binkul/Atari_65XE_scheme/README.md

# Atari_65XE_scheme
1) Improve GND project
2) Remove GTIA fixer (can be made over normal position)
3) 1 MB by Pasiu was added directy on board
4) Video is made by THT elements
5) Four OS
6) Up to eight Super Cartridges inside (MAC65, Action!, Basic XE, Basic XL, Atari Basic)
