binkul/Atari_65XE_scheme/Atari ITX SCH.pdf

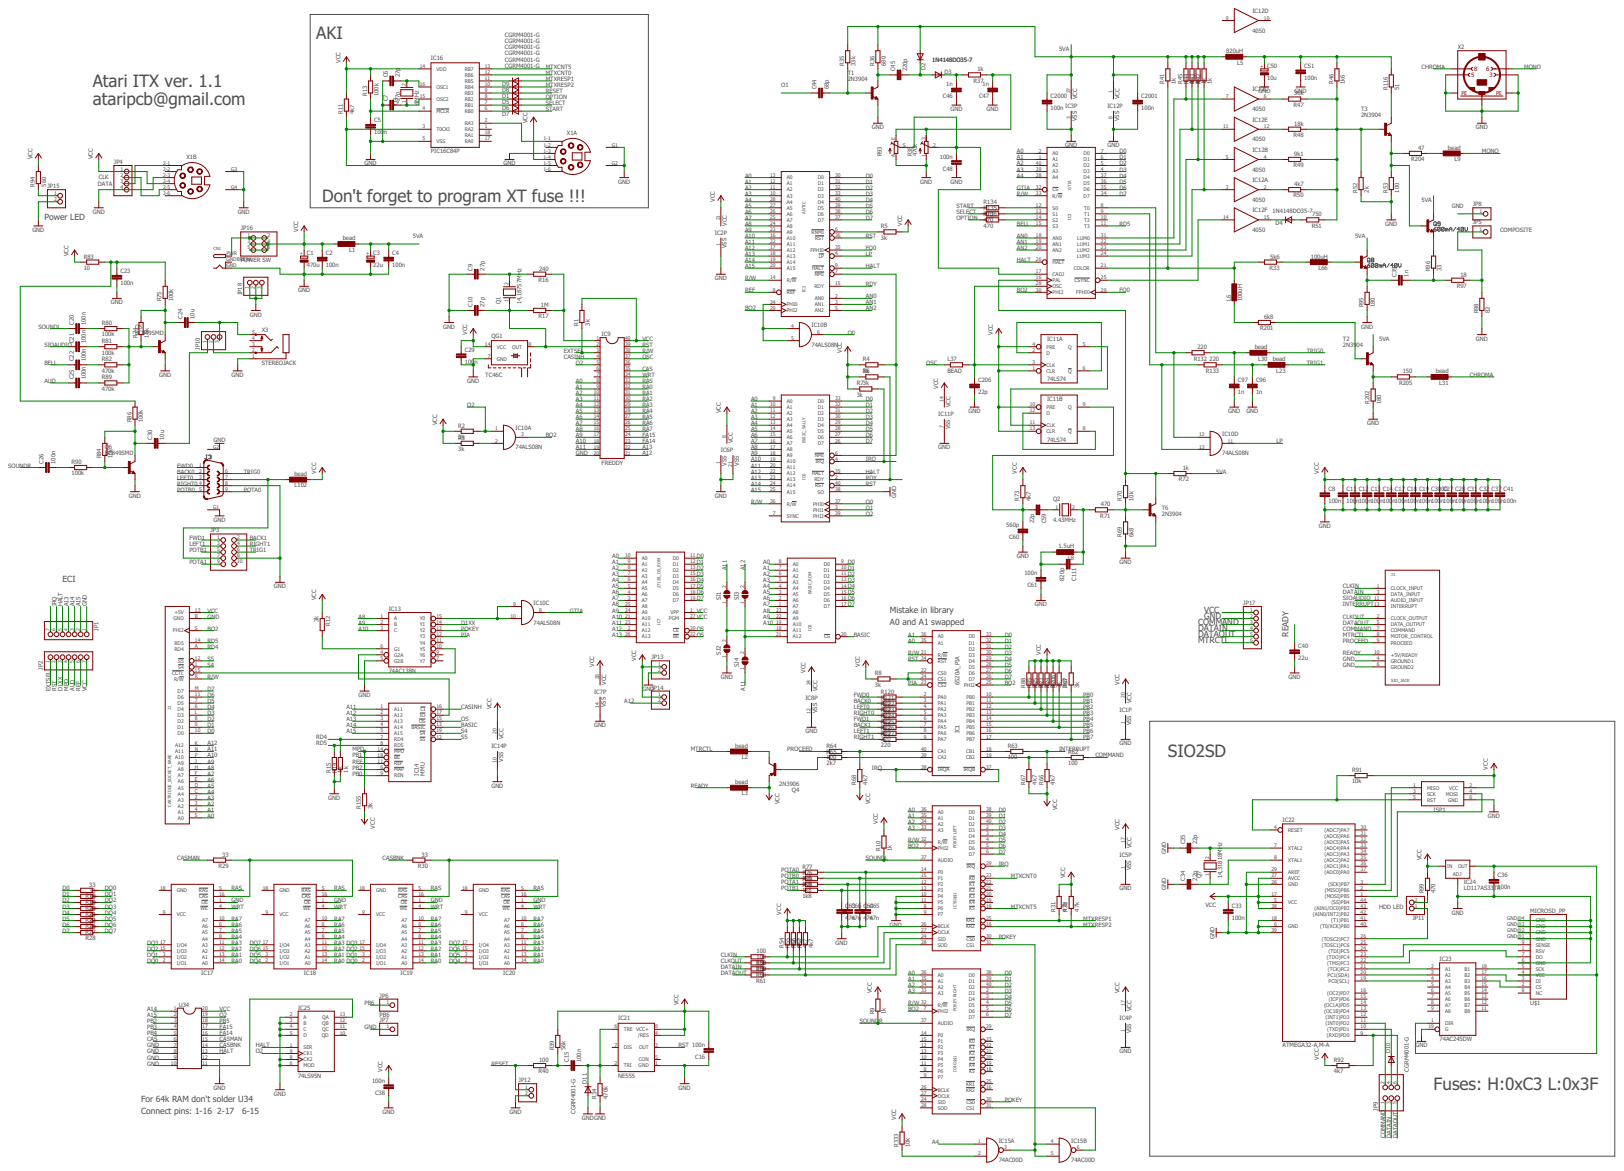
[picture p1: page 1]

Don't forget to program XT fuse !!!

VSS VSS VCC VSS

VCC VSS

For 64k RAM don't solder U34
Connect pins: 1-16 2-17 6-15
