binkul/Atari_65XE_scheme/Atari 130XE.kicad_pcb

## KiCad design Atari 130XE.kicad_pcb (2020-11-24)

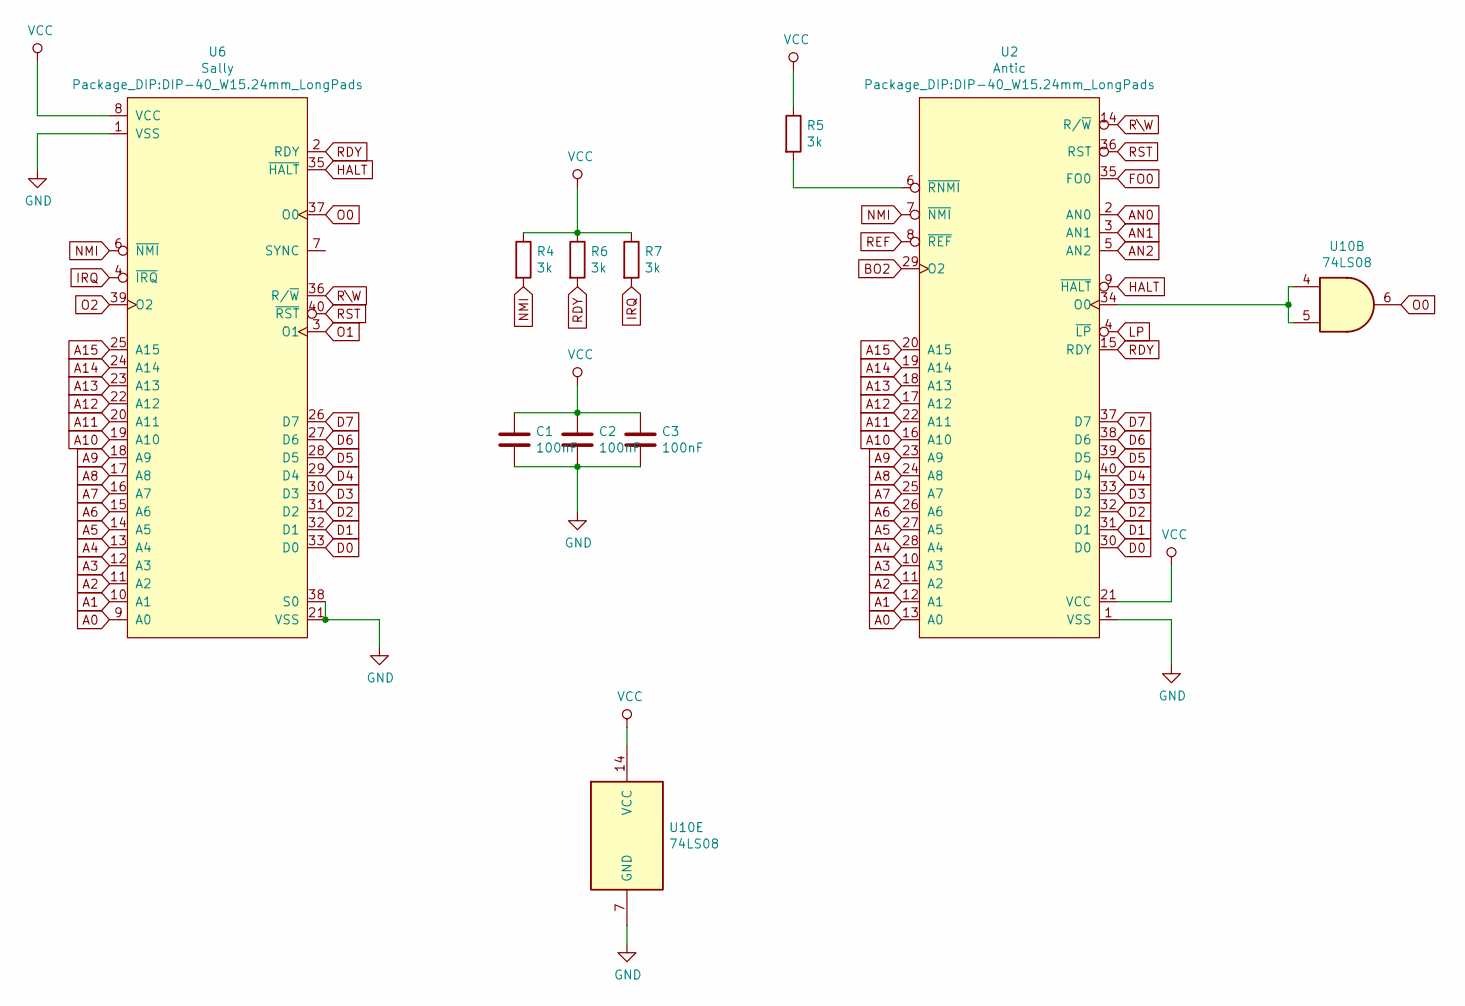
[picture p2: schematic Sally and Antic.sch]

Parts:
C1, C2, C3: 100nF; C_Disc_D5.0mm_W2.5mm_P5.00mm
R4, R5, R6, R7: 3k; R_Axial_DIN0207_L3.6mm_D2.2mm_P10.16mm_Horizontal
U2: Antic; DIP-40_W15.24mm_LongPads
U6: Sally; DIP-40_W15.24mm_LongPads
U10: 74LS08; DIP-14_W7.62mm_Socket_LongPads

Connections:
A0: U2.13 (A0), U6.9 (A0); also elsewhere on the board
A1: U2.12 (A1), U6.10 (A1); also elsewhere on the board
A2: U2.11 (A2), U6.11 (A2); also elsewhere on the board
A3: U2.10 (A3), U6.12 (A3); also elsewhere on the board
A4: U2.28 (A4), U6.13 (A4); also elsewhere on the board
A5: U2.27 (A5), U6.14 (A5); also elsewhere on the board
A6: U2.26 (A6), U6.15 (A6); also elsewhere on the board
A7: U2.25 (A7), U6.16 (A7); also elsewhere on the board
A8: U2.24 (A8), U6.17 (A8); also elsewhere on the board
A9: U2.23 (A9), U6.18 (A9); also elsewhere on the board
A10: U2.16 (A10), U6.19 (A10); also elsewhere on the board
A11: U2.22 (A11), U6.20 (A11); also elsewhere on the board
A12: U2.17 (A12), U6.22 (A12); also elsewhere on the board
A13: U2.18 (A13), U6.23 (A13); also elsewhere on the board
A14: U2.19 (A14), U6.24 (A14); also elsewhere on the board
A15: U2.20 (A15), U6.25 (A15); also elsewhere on the board
AN0: U2.2 (AN0); also elsewhere on the board
AN1: U2.3 (AN1); also elsewhere on the board
AN2: U2.5 (AN2); also elsewhere on the board
BO2: U2.29 (O2); also elsewhere on the board
D0: U2.30 (D0), U6.33 (D0); also elsewhere on the board
D1: U2.31 (D1), U6.32 (D1); also elsewhere on the board
D2: U2.32 (D2), U6.31 (D2); also elsewhere on the board
D3: U2.33 (D3), U6.30 (D3); also elsewhere on the board
D4: U2.40 (D4), U6.29 (D4); also elsewhere on the board
D5: U2.39 (D5), U6.28 (D5); also elsewhere on the board
D6: U2.38 (D6), U6.27 (D6); also elsewhere on the board
D7: U2.37 (D7), U6.26 (D7); also elsewhere on the board
FO0: U2.35 (FO0); also elsewhere on the board
GND: C1.2, C2.2, C3.2, U2.1 (VSS), U6.1 (VSS), U6.21 (VSS), U6.38 (S0), U10.7 (GND); also elsewhere on the board
HALT: U2.9 (~HALT), U6.35 (~HALT); also elsewhere on the board
IRQ: R7.2, U6.4 (~IRQ); also elsewhere on the board
LP: U2.4 (~LP); also elsewhere on the board
NMI: R4.2, U2.7 (~NMI), U6.6 (~NMI)
unnamed: R5.2, U2.6 (~RNMI)
unnamed: U2.34 (O0), U10.4, U10.5
O0: U6.37 (O0), U10.6; also elsewhere on the board
O1: U6.3 (O1); also elsewhere on the board
O2: U6.39 (O2); also elsewhere on the board
RDY: R6.2, U2.15 (RDY), U6.2 (RDY)
REF: U2.8 (~REF); also elsewhere on the board
RST: U2.36 (RST), U6.40 (~RST); also elsewhere on the board
R\W: U2.14 (R/~W), U6.36 (R/~W); also elsewhere on the board
VCC: C1.1, C2.1, C3.1, R4.1, R5.1, R6.1, R7.1, U2.21 (VCC), U6.8 (VCC), U10.14 (VCC); also elsewhere on the board

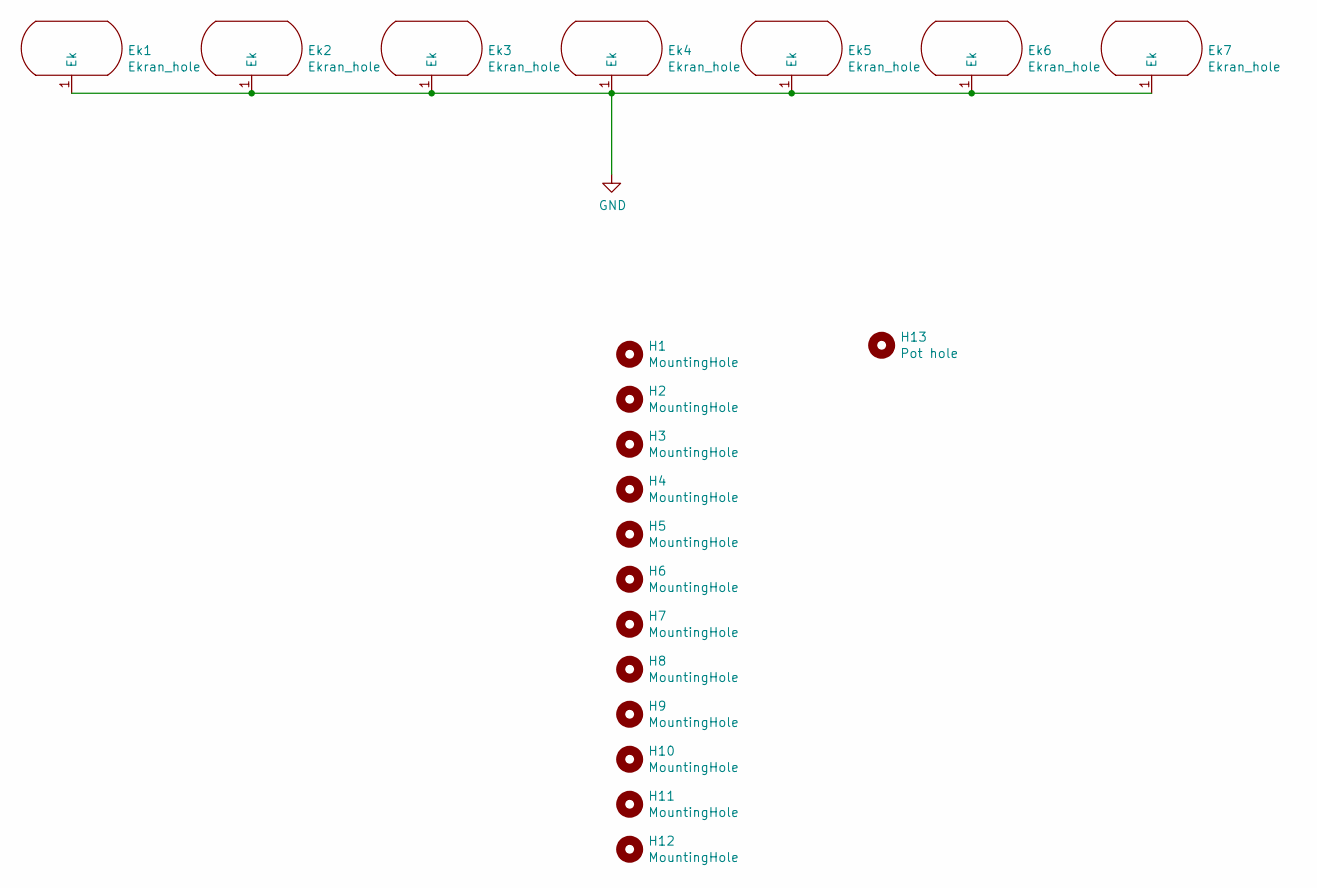
[picture p3: schematic Holes.sch]

Parts:
Ek1, Ek2, Ek3, Ek4, Ek5, Ek6, Ek7: Ekran_hole; Ekran_GND
H1, H2: MountingHole; Big_hole
H3, H4: MountingHole; Medium_hole
H5, H6, H7, H10, H11, H12: MountingHole; Hole_3.4mm
H8, H9: MountingHole; Hole_4.4mm
H13: Pot hole; MountingHole_3.2mm_M3

Connections:
GND: Ek1.1, Ek2.1, Ek3.1, Ek4.1, Ek5.1, Ek6.1, Ek7.1; also elsewhere on the board

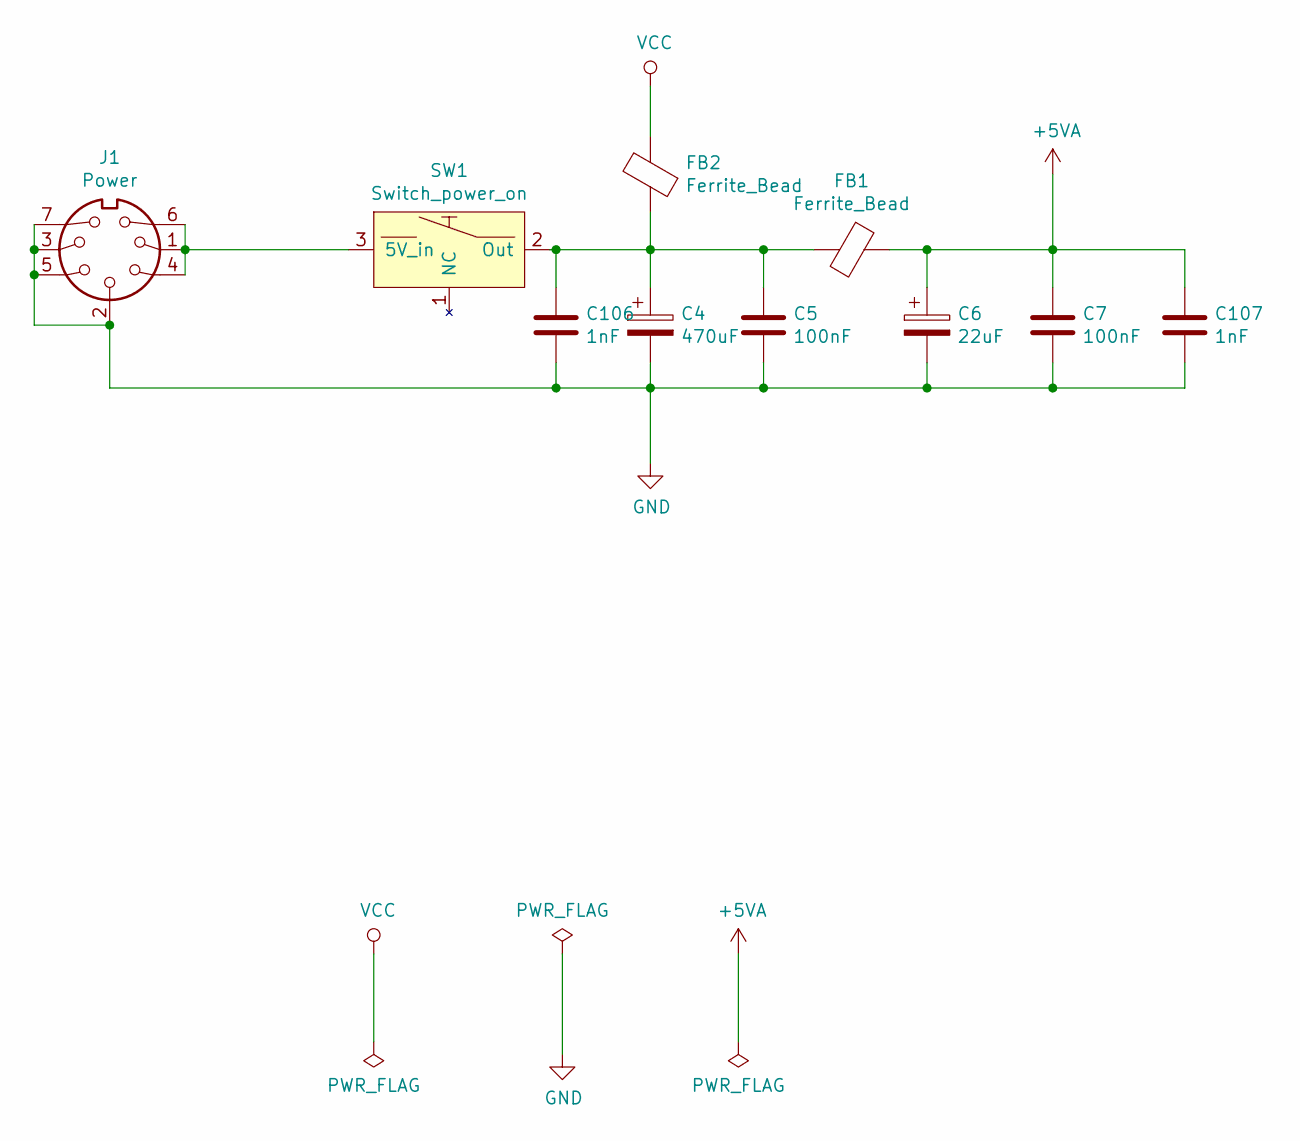
[picture p4: schematic Power.sch]

Parts:
C4: 470uF; CP_Radial_D10.0mm_P5.00mm
C5, C7: 100nF; C_Disc_D5.0mm_W2.5mm_P5.00mm
C6: 22uF; CP_Radial_D5.0mm_P2.00mm
C106, C107: 1nF; C_Disc_D5.0mm_W2.5mm_P5.00mm
FB1, FB2: Ferrite_Bead; L_Axial_L9.5mm_D4.0mm_P12.70mm_Horizontal_Fastron_SMCC
J1: Power; DIN_7_pin
SW1: Switch_power_on; Switch_ON-OFF

Connections:
+5VA: C6.1, C7.1, C107.1, FB1.1; also elsewhere on the board
GND: C4.2, C5.2, C6.2, C7.2, C106.2, C107.2, J1.2, J1.3, J1.5, J1.7; also elsewhere on the board
unnamed: C4.1, C5.1, C106.1, FB1.2, FB2.1, SW1.2 (Out)
unnamed: J1.1, J1.4, J1.6, SW1.3 (5V_in)
VCC: FB2.2; also elsewhere on the board

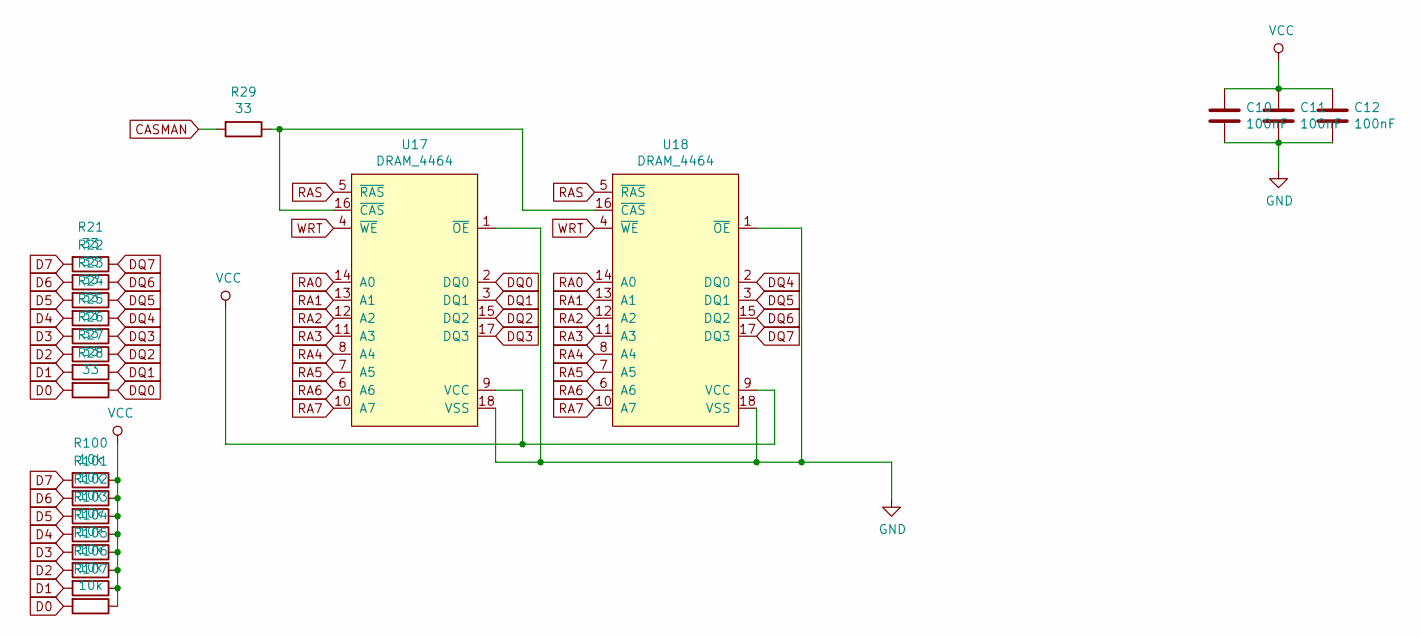
[picture p5: schematic Memory.sch]

Parts:
C10, C11, C12: 100nF; C_Disc_D5.0mm_W2.5mm_P5.00mm
R21, R22, R23, R24, R25, R26, R27, R28: 33; R_1206_3216Metric_Pad1.42x1.75mm_HandSolder
R29: 33; R_Axial_DIN0207_L3.6mm_D2.2mm_P10.16mm_Horizontal
R100, R101, R102, R103, R104, R105, R106, R107: 10k; R_1206_3216Metric_Pad1.42x1.75mm_HandSolder
U17, U18: DRAM_4464; DIP-18_W7.62mm_LongPads

Connections:
CASMAN: R29.2; also elsewhere on the board
D0: R28.2, R107.2; also elsewhere on the board
D1: R27.2, R106.2; also elsewhere on the board
D2: R26.2, R105.2; also elsewhere on the board
D3: R25.2, R104.2; also elsewhere on the board
D4: R24.2, R103.2; also elsewhere on the board
D5: R23.2, R102.2; also elsewhere on the board
D6: R22.2, R101.2; also elsewhere on the board
D7: R21.2, R100.2; also elsewhere on the board
DQ0: R28.1, U17.2 (DQ0); also elsewhere on the board
DQ1: R27.1, U17.3 (DQ1); also elsewhere on the board
DQ2: R26.1, U17.15 (DQ2); also elsewhere on the board
DQ3: R25.1, U17.17 (DQ3); also elsewhere on the board
DQ4: R24.1, U18.2 (DQ0); also elsewhere on the board
DQ5: R23.1, U18.3 (DQ1); also elsewhere on the board
DQ6: R22.1, U18.15 (DQ2); also elsewhere on the board
DQ7: R21.1, U18.17 (DQ3); also elsewhere on the board
GND: C10.2, C11.2, C12.2, U17.1 (~OE), U17.18 (VSS), U18.1 (~OE), U18.18 (VSS); also elsewhere on the board
unnamed: R29.1, U17.16 (~CAS), U18.16 (~CAS)
RA0: U17.14 (A0), U18.14 (A0); also elsewhere on the board
RA1: U17.13 (A1), U18.13 (A1); also elsewhere on the board
RA2: U17.12 (A2), U18.12 (A2); also elsewhere on the board
RA3: U17.11 (A3), U18.11 (A3); also elsewhere on the board
RA4: U17.8 (A4), U18.8 (A4); also elsewhere on the board
RA5: U17.7 (A5), U18.7 (A5); also elsewhere on the board
RA6: U17.6 (A6), U18.6 (A6); also elsewhere on the board
RA7: U17.10 (A7), U18.10 (A7); also elsewhere on the board
RAS: U17.5 (~RAS), U18.5 (~RAS); also elsewhere on the board
VCC: C10.1, C11.1, C12.1, R100.1, R101.1, R102.1, R103.1, R104.1, R105.1, R106.1, R107.1, U17.9 (VCC), U18.9 (VCC); also elsewhere on the board
WRT: U17.4 (~WE), U18.4 (~WE); also elsewhere on the board

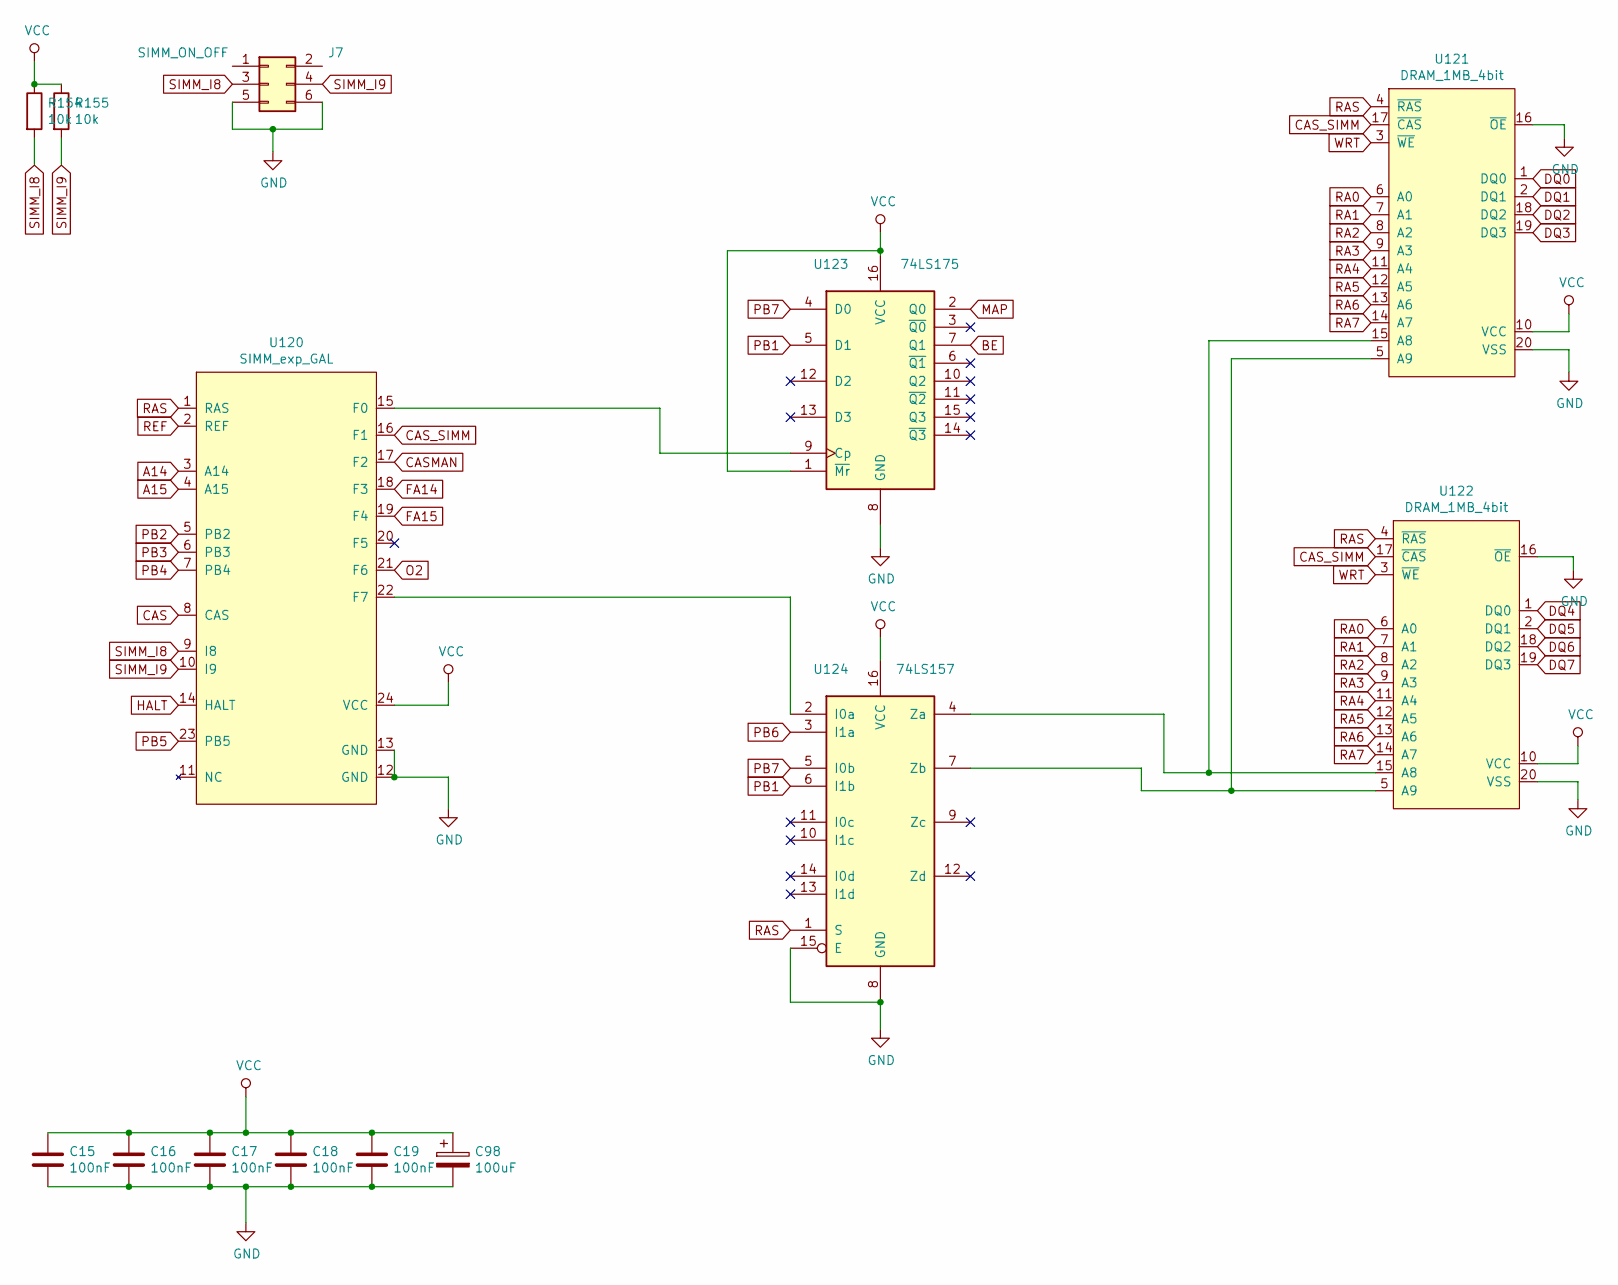
[picture p6: schematic External Memory.sch, External 196Kb]

Parts:
C15, C16, C17: 100nF; C_Disc_D5.0mm_W2.5mm_P5.00mm
C18, C19: 100nF; C_1206_3216Metric_Pad1.42x1.75mm_HandSolder
C98: 100uF; CP_Radial_D6.3mm_P2.50mm
J7: SIMM_ON_OFF; PinHeader_2x03_P2.54mm_Vertical
R154, R155: 10k; R_1206_3216Metric_Pad1.42x1.75mm_HandSolder
U120: SIMM_exp_GAL; DIP-24_W7.62mm_Socket_LongPads
U121, U122: DRAM_1MB_4bit; SOJ-26
U123: 74LS175; SOIC-16_3.9x9.9mm_P1.27mm
U124: 74LS157; SOIC-16_3.9x9.9mm_P1.27mm

Connections:
A14: U120.3 (A14); also elsewhere on the board
A15: U120.4 (A15); also elsewhere on the board
BE: U123.7 (Q1); also elsewhere on the board
CAS: U120.8 (CAS); also elsewhere on the board
CASMAN: U120.17 (F2); also elsewhere on the board
CAS_SIMM: U120.16 (F1), U121.17 (~CAS), U122.17 (~CAS)
DQ0: U121.1 (DQ0); also elsewhere on the board
DQ1: U121.2 (DQ1); also elsewhere on the board
DQ2: U121.18 (DQ2); also elsewhere on the board
DQ3: U121.19 (DQ3); also elsewhere on the board
DQ4: U122.1 (DQ0); also elsewhere on the board
DQ5: U122.2 (DQ1); also elsewhere on the board
DQ6: U122.18 (DQ2); also elsewhere on the board
DQ7: U122.19 (DQ3); also elsewhere on the board
FA14: U120.18 (F3); also elsewhere on the board
FA15: U120.19 (F4); also elsewhere on the board
GND: C15.2, C16.2, C17.2, C18.2, C19.2, C98.2, J7.5, J7.6, U120.12 (GND), U120.13 (GND), U121.16 (~OE), U121.20 (VSS), U122.16 (~OE), U122.20 (VSS), U123.8 (GND), U124.8 (GND), U124.15 (E); also elsewhere on the board
HALT: U120.14 (HALT); also elsewhere on the board
MAP: U123.2 (Q0); also elsewhere on the board
unnamed: U120.15 (F0), U123.9 (Cp)
unnamed: U120.22 (F7), U124.2 (I0a)
unnamed: U121.5 (A9), U122.5 (A9), U124.7 (Zb)
unnamed: U121.15 (A8), U122.15 (A8), U124.4 (Za)
O2: U120.21 (F6); also elsewhere on the board
PB1: U123.5 (D1), U124.6 (I1b); also elsewhere on the board
PB2: U120.5 (PB2); also elsewhere on the board
PB3: U120.6 (PB3); also elsewhere on the board
PB4: U120.7 (PB4); also elsewhere on the board
PB5: U120.23 (PB5); also elsewhere on the board
PB6: U124.3 (I1a); also elsewhere on the board
PB7: U123.4 (D0), U124.5 (I0b); also elsewhere on the board
RA0: U121.6 (A0), U122.6 (A0); also elsewhere on the board
RA1: U121.7 (A1), U122.7 (A1); also elsewhere on the board
RA2: U121.8 (A2), U122.8 (A2); also elsewhere on the board
RA3: U121.9 (A3), U122.9 (A3); also elsewhere on the board
RA4: U121.11 (A4), U122.11 (A4); also elsewhere on the board
RA5: U121.12 (A5), U122.12 (A5); also elsewhere on the board
RA6: U121.13 (A6), U122.13 (A6); also elsewhere on the board
RA7: U121.14 (A7), U122.14 (A7); also elsewhere on the board
RAS: U120.1 (RAS), U121.4 (~RAS), U122.4 (~RAS), U124.1 (S); also elsewhere on the board
REF: U120.2 (REF); also elsewhere on the board
SIMM_I8: J7.3, R154.2, U120.9 (I8)
SIMM_I9: J7.4, R155.2, U120.10 (I9)
VCC: C15.1, C16.1, C17.1, C18.1, C19.1, C98.1, R154.1, R155.1, U120.24 (VCC), U121.10 (VCC), U122.10 (VCC), U123.1 (~Mr), U123.16 (VCC), U124.16 (VCC); also elsewhere on the board
WRT: U121.3 (~WE), U122.3 (~WE); also elsewhere on the board

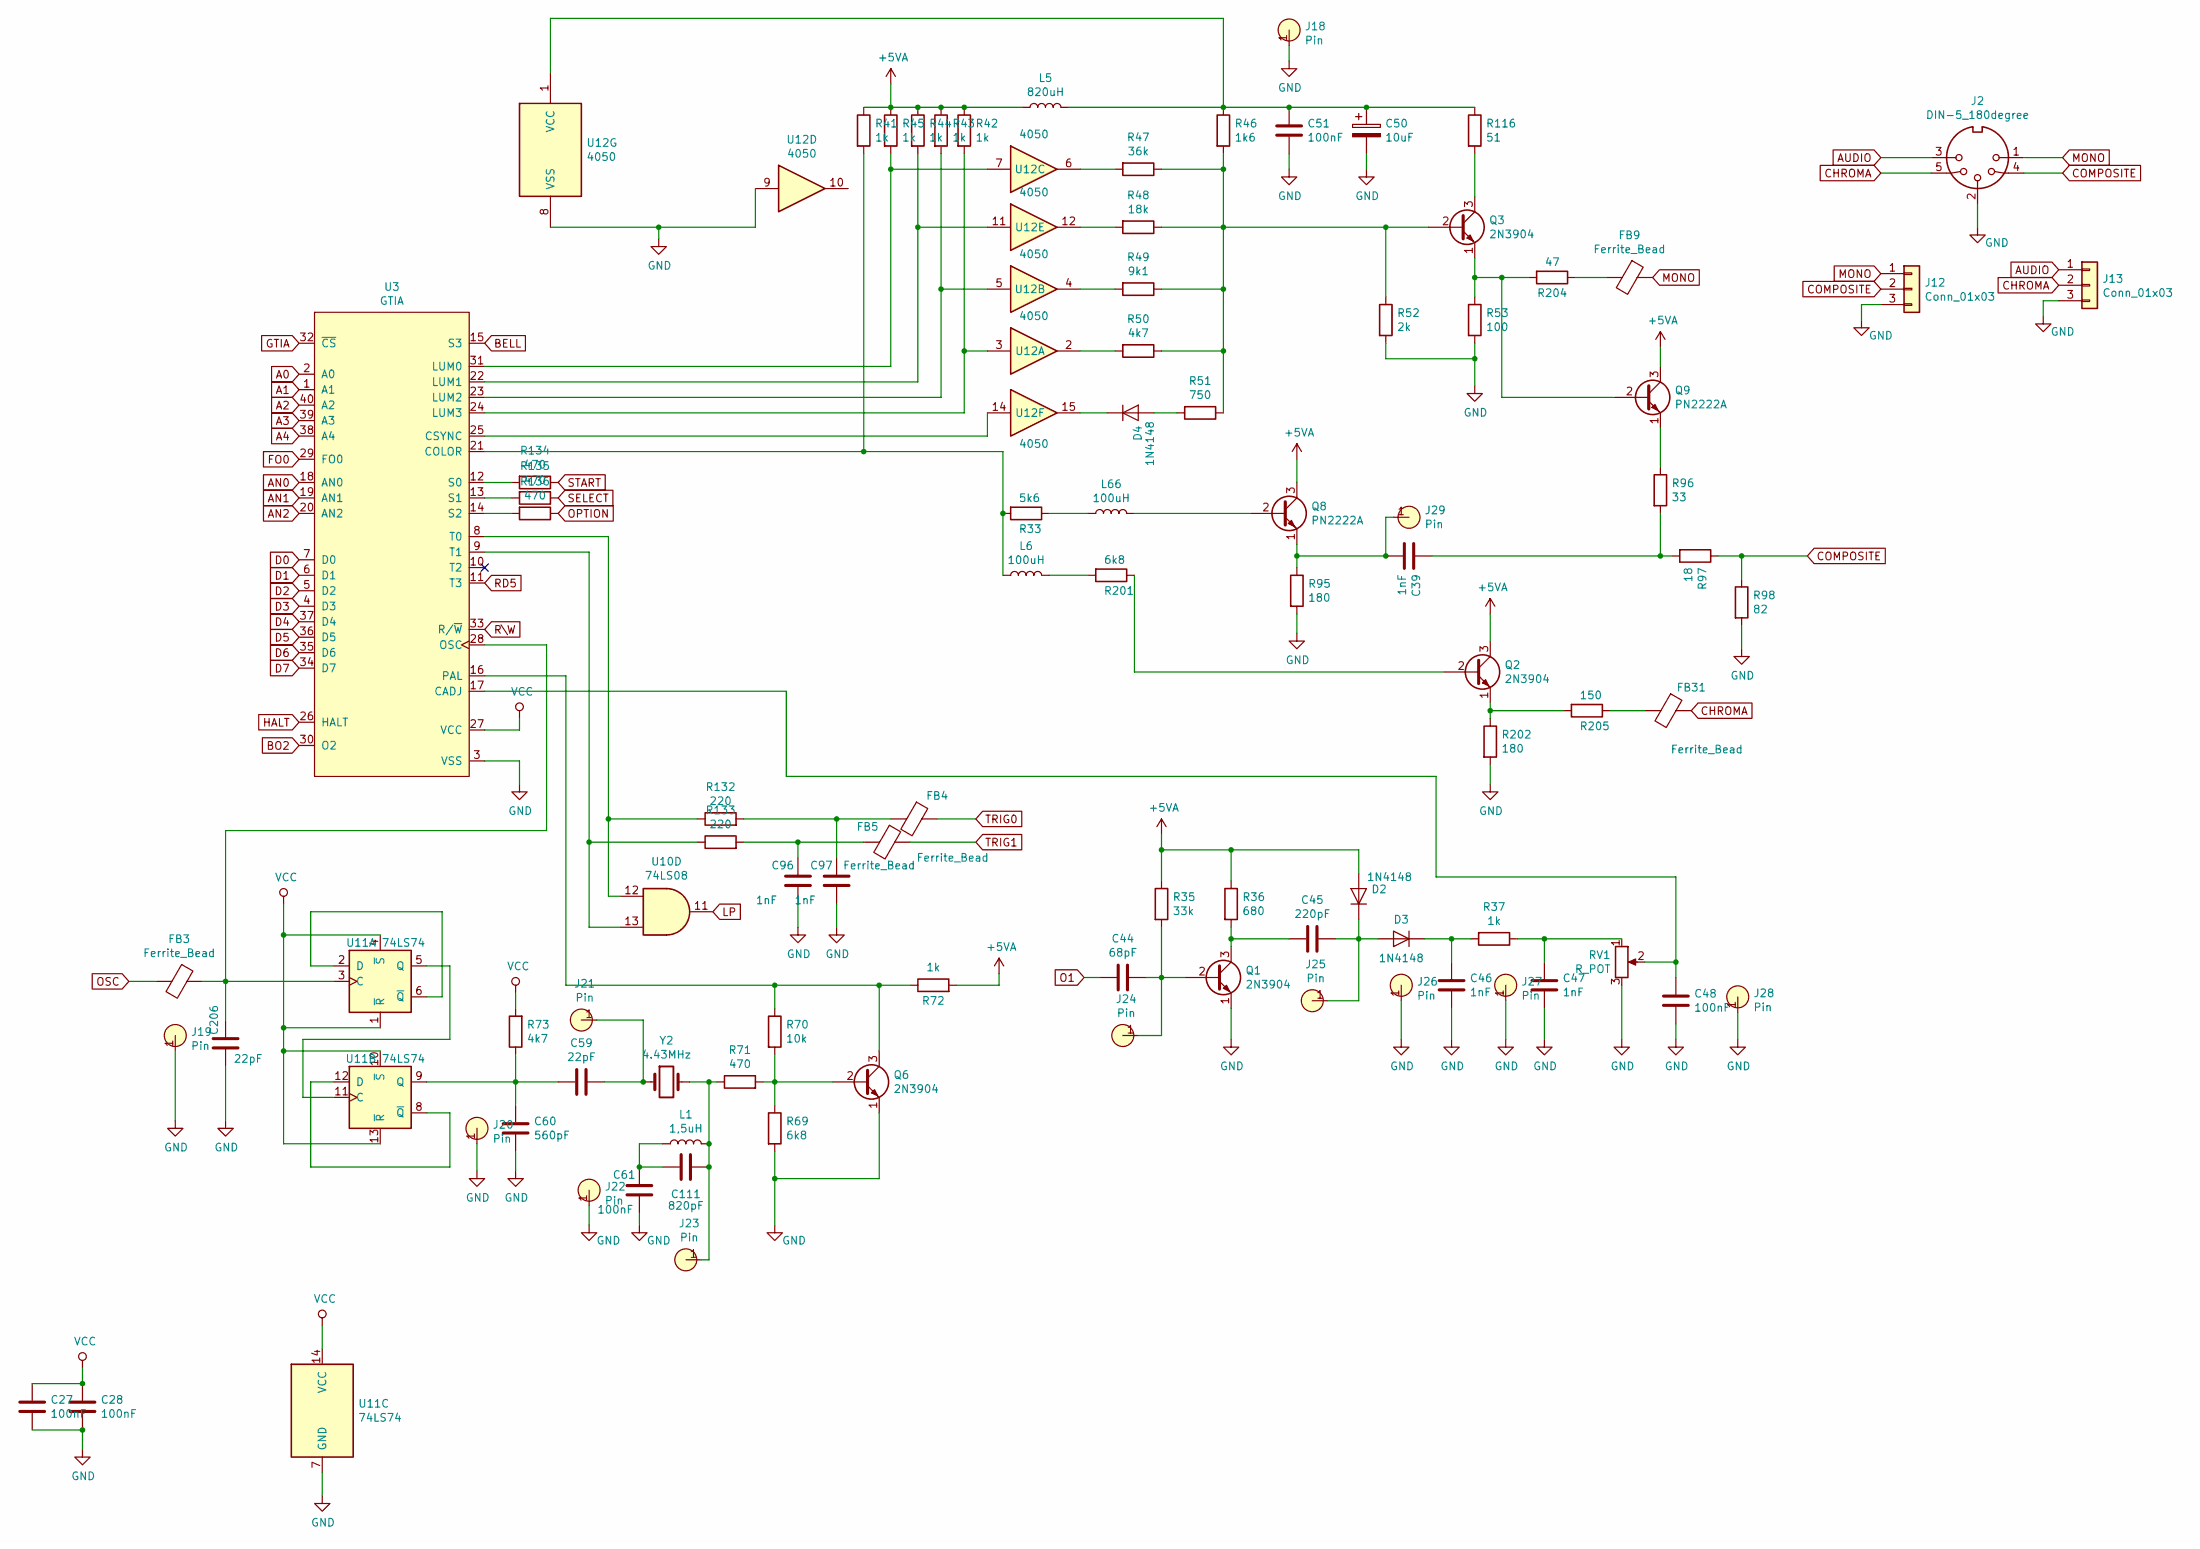
[picture p7: schematic GTIA.sch]

Parts:
C27, C28, C48, C51, C61: 100nF; C_Disc_D5.0mm_W2.5mm_P5.00mm
C39, C46, C47, C96, C97: 1nF; C_Disc_D5.0mm_W2.5mm_P5.00mm
C44: 68pF; C_Disc_D3.0mm_W2.0mm_P2.50mm
C45: 220pF; C_Disc_D5.0mm_W2.5mm_P5.00mm
C50: 10uF; CP_Radial_D6.3mm_P2.50mm
C59, C206: 22pF; C_Disc_D5.0mm_W2.5mm_P5.00mm
C60: 560pF; C_Disc_D5.0mm_W2.5mm_P5.00mm
C111: 820pF; C_Disc_D5.0mm_W2.5mm_P5.00mm
D2, D3, D4: 1N4148; D_DO-34_SOD68_P10.16mm_Horizontal
FB3, FB4, FB5, FB9, FB31: Ferrite_Bead; L_Axial_L7.0mm_D3.3mm_P10.16mm_Horizontal_Fastron_MICC
J2: DIN-5_180degree; DIN_5_pin
J12, J13: Conn_01x03; PinHeader_1x03_P2.54mm_Vertical
J18, J19, J20, J21, J22, J23, J24, J25, J26, J27, J28, J29: Pin
L1: 1,5uH; L_Axial_L5.3mm_D2.2mm_P10.16mm_Horizontal_Vishay_IM-1
L5: 820uH; L_Axial_L5.3mm_D2.2mm_P10.16mm_Horizontal_Vishay_IM-1
L6, L66: 100uH; L_Axial_L5.3mm_D2.2mm_P10.16mm_Horizontal_Vishay_IM-1
Q1, Q2, Q3, Q6: 2N3904; TO-92_Inline
Q8, Q9: PN2222A; TO-92_Inline
R33: 5k6; R_Axial_DIN0207_L3.6mm_D2.2mm_P10.16mm_Horizontal
R35: 33k; R_Axial_DIN0207_L3.6mm_D2.2mm_P10.16mm_Horizontal
R36: 680; R_Axial_DIN0207_L3.6mm_D2.2mm_P10.16mm_Horizontal
R37, R41, R42, R43, R44, R45, R72: 1k; R_Axial_DIN0207_L3.6mm_D2.2mm_P10.16mm_Horizontal
R46: 1k6; R_Axial_DIN0207_L3.6mm_D2.2mm_P10.16mm_Horizontal
R47: 36k; R_Axial_DIN0207_L3.6mm_D2.2mm_P10.16mm_Horizontal
R48: 18k; R_Axial_DIN0207_L3.6mm_D2.2mm_P10.16mm_Horizontal
R49: 9k1; R_Axial_DIN0207_L3.6mm_D2.2mm_P10.16mm_Horizontal
R50, R73: 4k7; R_Axial_DIN0207_L3.6mm_D2.2mm_P10.16mm_Horizontal
R51: 750; R_Axial_DIN0207_L3.6mm_D2.2mm_P10.16mm_Horizontal
R52: 2k; R_Axial_DIN0207_L3.6mm_D2.2mm_P10.16mm_Horizontal
R53: 100; R_Axial_DIN0207_L3.6mm_D2.2mm_P10.16mm_Horizontal
R69, R201: 6k8; R_Axial_DIN0207_L3.6mm_D2.2mm_P10.16mm_Horizontal
R70: 10k; R_Axial_DIN0207_L3.6mm_D2.2mm_P10.16mm_Horizontal
R71: 470; R_Axial_DIN0207_L3.6mm_D2.2mm_P10.16mm_Horizontal
R95, R202: 180; R_Axial_DIN0207_L3.6mm_D2.2mm_P10.16mm_Horizontal
R96: 33; R_Axial_DIN0207_L3.6mm_D2.2mm_P10.16mm_Horizontal
R97: 18; R_Axial_DIN0207_L3.6mm_D2.2mm_P10.16mm_Horizontal
R98: 82; R_Axial_DIN0207_L3.6mm_D2.2mm_P10.16mm_Horizontal
R116: 51; R_Axial_DIN0207_L3.6mm_D2.2mm_P10.16mm_Horizontal
R132, R133: 220; R_1206_3216Metric_Pad1.42x1.75mm_HandSolder
R134, R135, R136: 470; R_1206_3216Metric_Pad1.42x1.75mm_HandSolder
R204: 47; R_Axial_DIN0207_L3.6mm_D2.2mm_P10.16mm_Horizontal
R205: 150; R_Axial_DIN0207_L3.6mm_D2.2mm_P10.16mm_Horizontal
RV1: R_POT; Potentiometer_ACP_CA9-V10_Vertical_Hole
U3: GTIA; DIP-40_W15.24mm_LongPads
U10: 74LS08; DIP-14_W7.62mm_Socket_LongPads
U11: 74LS74; DIP-14_W7.62mm_Socket
U12: 4050; DIP-16_W7.62mm_Socket
Y2: 4.43MHz; Crystal_HC18-U_Horizontal

Connections:
+5VA: D2.2 (A), L5.1, Q2.3 (C), Q8.3 (C), Q9.3 (C), R35.1, R36.1, R41.1, R42.1, R43.1, R44.1, R45.1, R72.2; also elsewhere on the board
A0: U3.2 (A0); also elsewhere on the board
A1: U3.1 (A1); also elsewhere on the board
A2: U3.40 (A2); also elsewhere on the board
A3: U3.39 (A3); also elsewhere on the board
A4: U3.38 (A4); also elsewhere on the board
AN0: U3.18 (AN0); also elsewhere on the board
AN1: U3.19 (AN1); also elsewhere on the board
AN2: U3.20 (AN2); also elsewhere on the board
AUDIO: J2.3, J13.1; also elsewhere on the board
BELL: U3.15 (S3); also elsewhere on the board
BO2: U3.30 (O2); also elsewhere on the board
CHROMA: FB31.1, J2.5, J13.2
COMPOSITE: J2.4, J12.2, R97.1, R98.1
D0: U3.7 (D0); also elsewhere on the board
D1: U3.6 (D1); also elsewhere on the board
D2: U3.5 (D2); also elsewhere on the board
D3: U3.4 (D3); also elsewhere on the board
D4: U3.37 (D4); also elsewhere on the board
D5: U3.36 (D5); also elsewhere on the board
D6: U3.35 (D6); also elsewhere on the board
D7: U3.34 (D7); also elsewhere on the board
FO0: U3.29 (FO0); also elsewhere on the board
GND: C27.2, C28.2, C46.1, C47.1, C48.1, C50.2, C51.1, C60.2, C61.2, C96.2, C97.2, C206.2, J2.2, J12.3, J13.3, J18.1, J19.1, J20.1, J22.1, J26.1, J27.1, J28.1, Q1.1 (E), Q6.1 (E), R52.2, R53.2, R69.2, R95.2, R98.2, R202.2, RV1.3, U3.3 (VSS), U11.7 (GND), U12.8 (VSS), U12.9; also elsewhere on the board
GTIA: U3.32 (~CS); also elsewhere on the board
HALT: U3.26 (HALT); also elsewhere on the board
LP: U10.11; also elsewhere on the board
MONO: FB9.1, J2.1, J12.1
unnamed: C39.1, J29.1, Q8.1 (E), R95.1
unnamed: C39.2, R96.2, R97.2
unnamed: C44.1, J24.1, Q1.2 (B), R35.2
unnamed: C45.1, D2.1 (K), D3.2 (A), J25.1
unnamed: C45.2, Q1.3 (C), R36.2
unnamed: C46.2, D3.1 (K), R37.2
unnamed: C47.2, R37.1, RV1.1
unnamed: C48.2, RV1.2, U3.17 (CADJ)
unnamed: C50.1, C51.2, L5.2, R46.1, R116.1, U12.1 (VCC)
unnamed: C59.1, J21.1, Y2.1
unnamed: C59.2, C60.1, R73.1, U11.9 (Q)
unnamed: C96.1, FB5.2, R133.2
unnamed: C97.1, FB4.2, R132.2
unnamed: C111.1, J23.1, L1.2, R71.1, Y2.2
unnamed: C61.1, C111.2, L1.1
unnamed: C206.1, FB3.1, U3.28 (OSC), U11.3 (C)
unnamed: D4.1 (K), U12.15
unnamed: D4.2 (A), R51.2
unnamed: FB9.2, R204.1
unnamed: FB31.2, R205.1
unnamed: L6.1, R33.2, R41.2, U3.21 (COLOR)
unnamed: L6.2, R201.2
unnamed: L66.1, R33.1
unnamed: L66.2, Q8.2 (B)
unnamed: Q2.1 (E), R202.1, R205.2
unnamed: Q2.2 (B), R201.1
unnamed: Q3.1 (E), Q9.2 (B), R53.1, R204.2
unnamed: Q3.2 (B), R46.2, R47.1, R48.1, R49.1, R50.1, R51.1, R52.1
unnamed: Q3.3 (C), R116.2
unnamed: Q6.2 (B), R69.1, R70.2, R71.2
unnamed: Q6.3 (C), R70.1, R72.1, U3.16 (PAL)
unnamed: Q9.1 (E), R96.1
unnamed: R42.2, U3.24 (LUM3), U12.3
unnamed: R43.2, U3.23 (LUM2), U12.5
unnamed: R44.2, U3.22 (LUM1), U12.11
unnamed: R45.2, U3.31 (LUM0), U12.7
unnamed: R47.2, U12.6
unnamed: R48.2, U12.12
unnamed: R49.2, U12.4
unnamed: R50.2, U12.2
unnamed: R132.1, U3.8 (T0), U10.12
unnamed: R133.1, U3.9 (T1), U10.13
unnamed: R134.2, U3.12 (S0)
unnamed: R135.2, U3.13 (S1)
unnamed: R136.2, U3.14 (S2)
unnamed: U11.2 (D), U11.6 (~Q)
unnamed: U11.5 (Q), U11.11 (C)
unnamed: U11.8 (~Q), U11.12 (D)
unnamed: U3.25 (CSYNC), U12.14
O1: C44.2; also elsewhere on the board
OPTION: R136.1; also elsewhere on the board
OSC: FB3.2; also elsewhere on the board
RD5: U3.11 (T3); also elsewhere on the board
R\W: U3.33 (R/~W); also elsewhere on the board
SELECT: R135.1; also elsewhere on the board
START: R134.1; also elsewhere on the board
TRIG0: FB4.1; also elsewhere on the board
TRIG1: FB5.1; also elsewhere on the board
VCC: C27.1, C28.1, R73.2, U3.27 (VCC), U11.1 (~R), U11.4 (~S), U11.10 (~S), U11.13 (~R), U11.14 (VCC); also elsewhere on the board

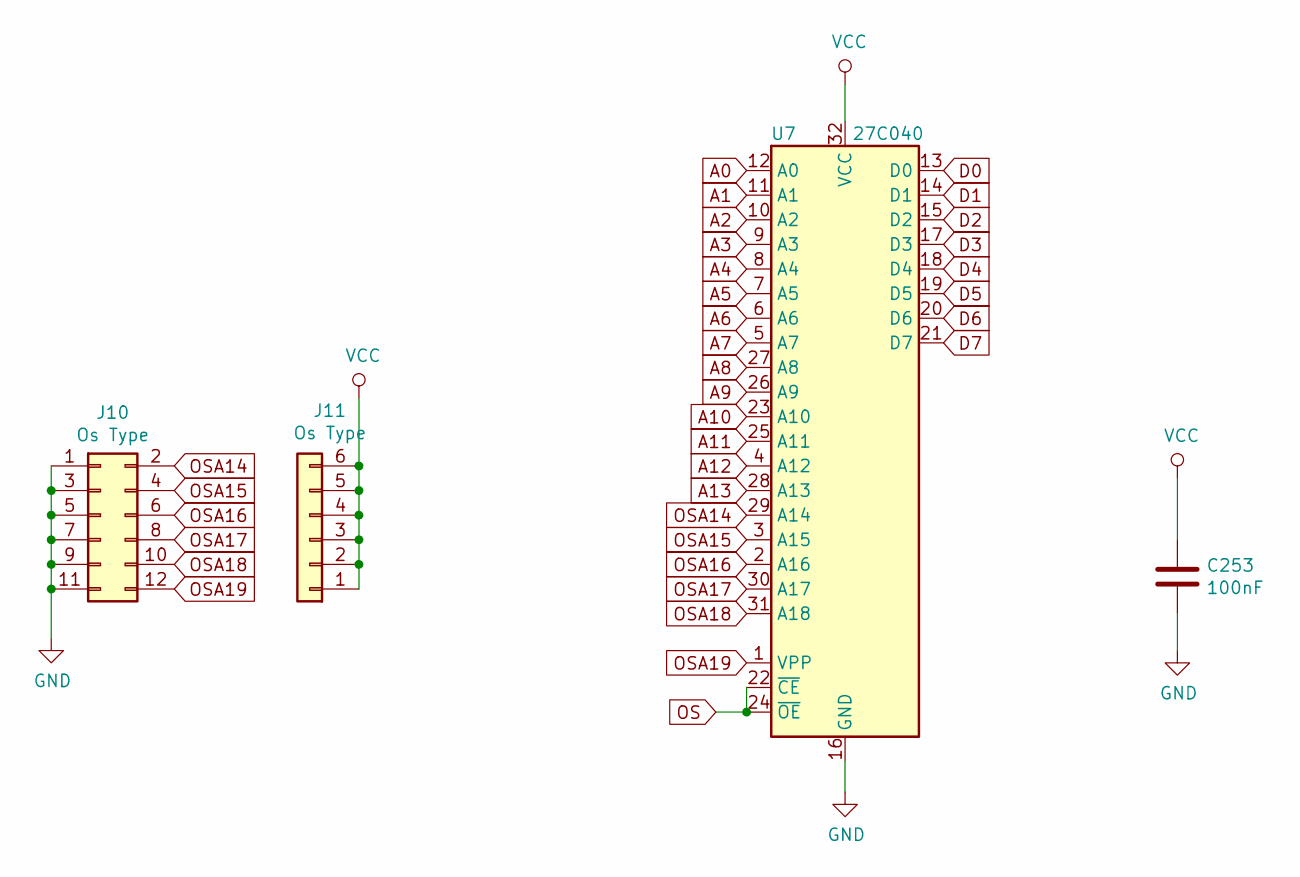
[picture p8: schematic Atari OS.sch]

Parts:
C253: 100nF; C_Disc_D5.0mm_W2.5mm_P5.00mm
J10: Os Type; PinHeader_2x06_P2.54mm_Vertical
J11: Os Type; PinHeader_1x06_P2.54mm_Vertical
U7: 27C040; DIP-32_W15.24mm_Socket_LongPads

Connections:
A0: U7.12 (A0); also elsewhere on the board
A1: U7.11 (A1); also elsewhere on the board
A2: U7.10 (A2); also elsewhere on the board
A3: U7.9 (A3); also elsewhere on the board
A4: U7.8 (A4); also elsewhere on the board
A5: U7.7 (A5); also elsewhere on the board
A6: U7.6 (A6); also elsewhere on the board
A7: U7.5 (A7); also elsewhere on the board
A8: U7.27 (A8); also elsewhere on the board
A9: U7.26 (A9); also elsewhere on the board
A10: U7.23 (A10); also elsewhere on the board
A11: U7.25 (A11); also elsewhere on the board
A12: U7.4 (A12); also elsewhere on the board
A13: U7.28 (A13); also elsewhere on the board
D0: U7.13 (D0); also elsewhere on the board
D1: U7.14 (D1); also elsewhere on the board
D2: U7.15 (D2); also elsewhere on the board
D3: U7.17 (D3); also elsewhere on the board
D4: U7.18 (D4); also elsewhere on the board
D5: U7.19 (D5); also elsewhere on the board
D6: U7.20 (D6); also elsewhere on the board
D7: U7.21 (D7); also elsewhere on the board
GND: C253.2, J10.1, J10.3, J10.5, J10.7, J10.9, J10.11, U7.16 (GND); also elsewhere on the board
OS: U7.22 (~CE), U7.24 (~OE); also elsewhere on the board
OSA14: J10.2, U7.29 (A14)
OSA15: J10.4, U7.3 (A15)
OSA16: J10.6, U7.2 (A16)
OSA17: J10.8, U7.30 (A17)
OSA18: J10.10, U7.31 (A18)
OSA19: J10.12, U7.1 (VPP)
VCC: C253.1, J11.1, J11.2, J11.3, J11.4, J11.5, J11.6, U7.32 (VCC); also elsewhere on the board
