binkul/Atari_65XE_scheme/Atari 130XE.kicad_pcb

## KiCad design Atari 130XE.kicad_pcb (continued)

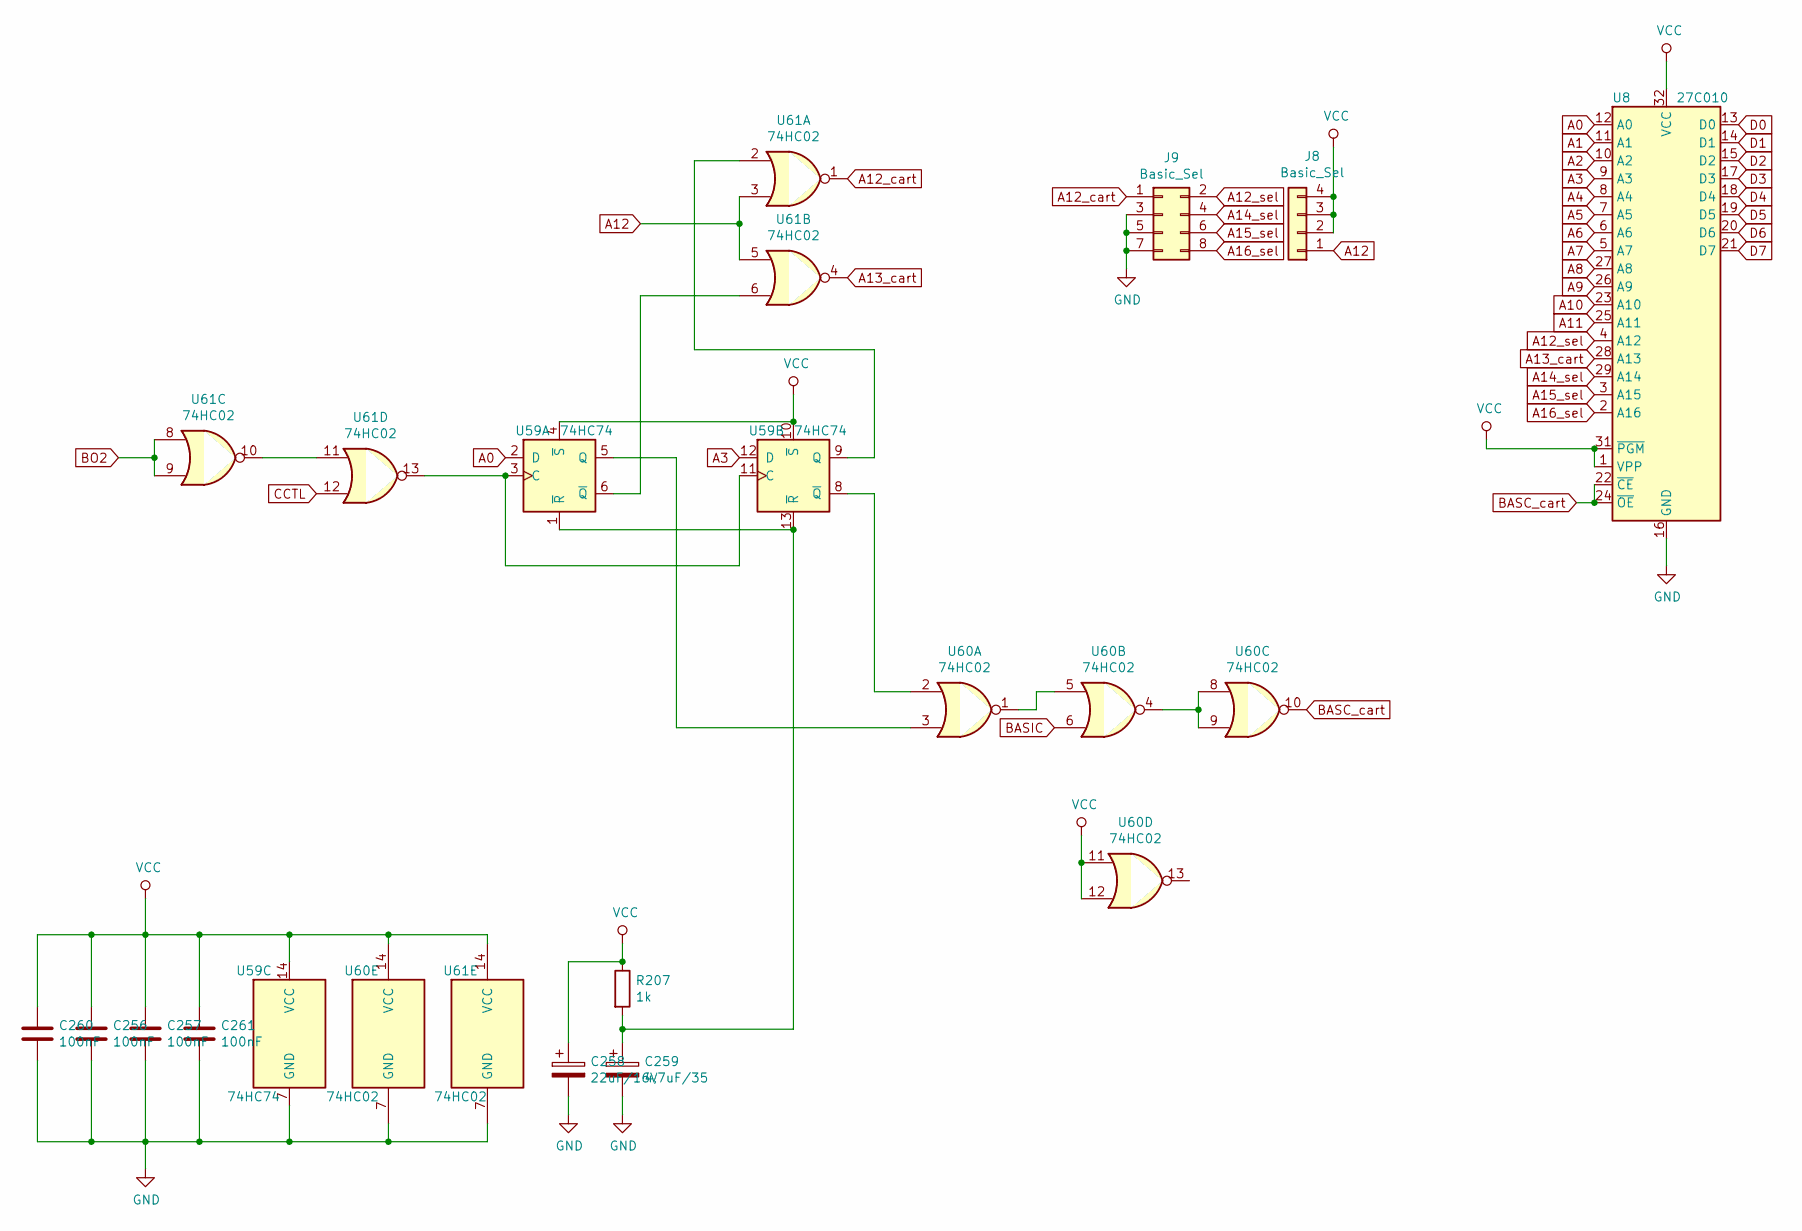
[picture p9: schematic Basic.sch]

Parts:
C256: 100nF; C_Disc_D6.0mm_W2.5mm_P5.00mm
C257, C260, C261: 100nF; C_1206_3216Metric_Pad1.42x1.75mm_HandSolder
C258: 22uF/16V; CP_Elec_4x5.3
C259: 4,7uF/35; CP_Elec_4x5.3
J8: Basic_Sel; PinHeader_1x04_P2.54mm_Vertical
J9: Basic_Sel; PinHeader_2x04_P2.54mm_Vertical
R207: 1k; R_1206_3216Metric_Pad1.42x1.75mm_HandSolder
U8: 27C010; DIP-32_W15.24mm_Socket_LongPads
U59: 74HC74; SOIC-14_3.9x8.7mm_P1.27mm
U60, U61: 74HC02; SOIC-14_3.9x8.7mm_P1.27mm

Connections:
A0: U8.12 (A0), U59.2 (D); also elsewhere on the board
A1: U8.11 (A1); also elsewhere on the board
A2: U8.10 (A2); also elsewhere on the board
A3: U8.9 (A3), U59.12 (D); also elsewhere on the board
A4: U8.8 (A4); also elsewhere on the board
A5: U8.7 (A5); also elsewhere on the board
A6: U8.6 (A6); also elsewhere on the board
A7: U8.5 (A7); also elsewhere on the board
A8: U8.27 (A8); also elsewhere on the board
A9: U8.26 (A9); also elsewhere on the board
A10: U8.23 (A10); also elsewhere on the board
A11: U8.25 (A11); also elsewhere on the board
A12: J8.1, U61.3, U61.5; also elsewhere on the board
A12_cart: J9.1, U61.1
A12_sel: J9.2, U8.4 (A12)
A13_cart: U8.28 (A13), U61.4
A14_sel: J9.4, U8.29 (A14)
A15_sel: J9.6, U8.3 (A15)
A16_sel: J9.8, U8.2 (A16)
BASC_cart: U8.22 (~CE), U8.24 (~OE), U60.10
BASIC: U60.6; also elsewhere on the board
BO2: U61.8, U61.9; also elsewhere on the board
CCTL: U61.12; also elsewhere on the board
D0: U8.13 (D0); also elsewhere on the board
D1: U8.14 (D1); also elsewhere on the board
D2: U8.15 (D2); also elsewhere on the board
D3: U8.17 (D3); also elsewhere on the board
D4: U8.18 (D4); also elsewhere on the board
D5: U8.19 (D5); also elsewhere on the board
D6: U8.20 (D6); also elsewhere on the board
D7: U8.21 (D7); also elsewhere on the board
GND: C256.2, C257.2, C258.2, C259.2, C260.2, C261.2, J9.3, J9.5, J9.7, U8.16 (GND), U59.7 (GND), U60.7 (GND), U61.7 (GND); also elsewhere on the board
unnamed: C259.1, R207.2, U59.1 (~R), U59.13 (~R)
unnamed: U59.5 (Q), U60.3
unnamed: U59.6 (~Q), U61.6
unnamed: U59.8 (~Q), U60.2
unnamed: U59.9 (Q), U61.2
unnamed: U59.3 (C), U59.11 (C), U61.13
unnamed: U60.1, U60.5
unnamed: U60.4, U60.8, U60.9
unnamed: U61.10, U61.11
VCC: C256.1, C257.1, C258.1, C260.1, C261.1, J8.2, J8.3, J8.4, R207.1, U8.1 (VPP), U8.31 (~PGM), U8.32 (VCC), U59.4 (~S), U59.10 (~S), U59.14 (VCC), U60.11, U60.12, U60.14 (VCC), U61.14 (VCC); also elsewhere on the board

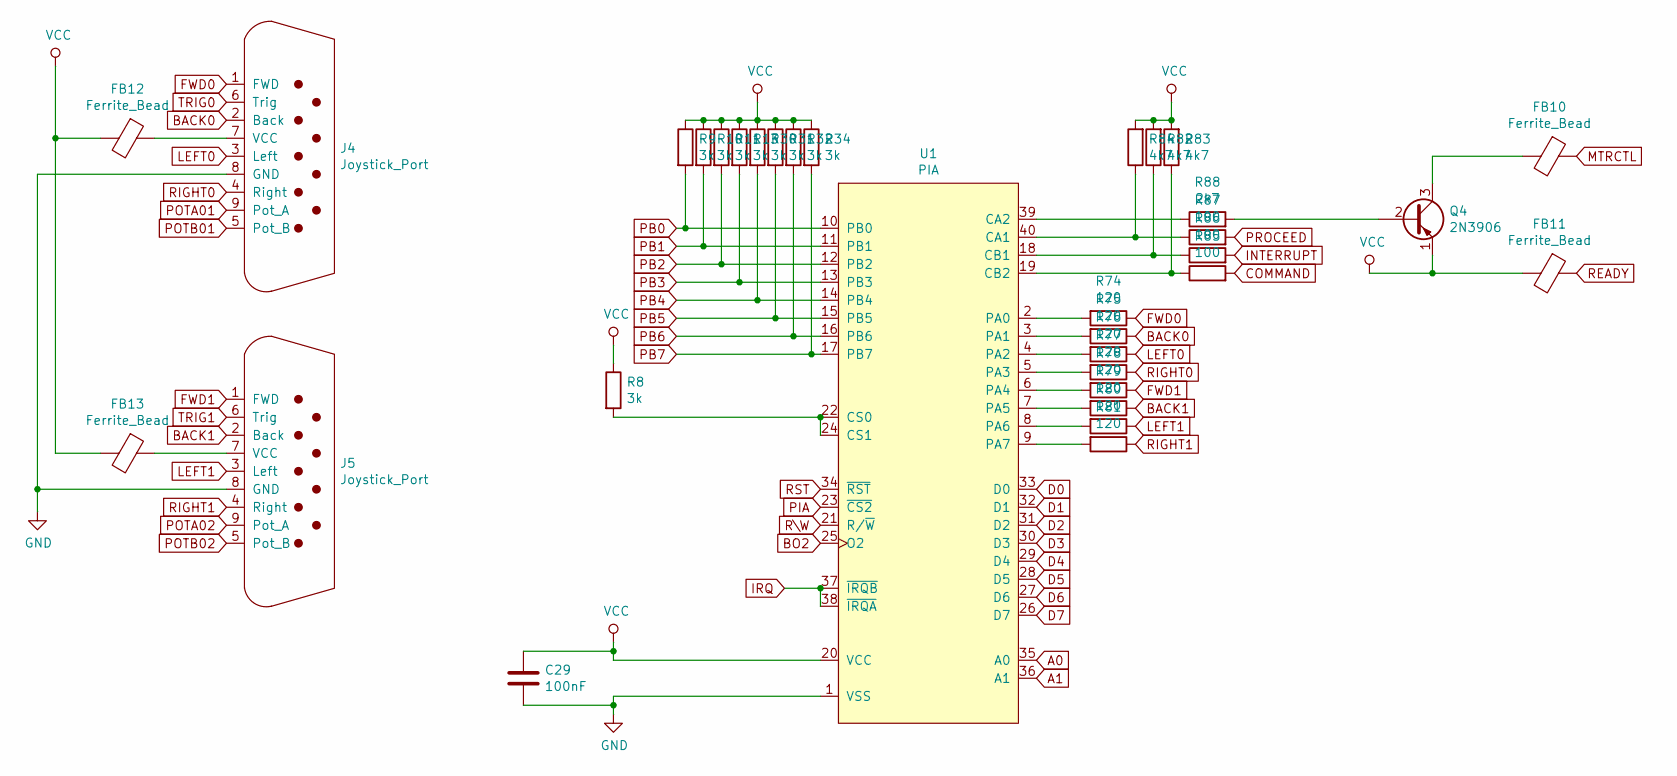
[picture p10: schematic PIA.sch]

Parts:
C29: 100nF; C_Disc_D5.0mm_W2.5mm_P5.00mm
FB10, FB11, FB12, FB13: Ferrite_Bead; L_Axial_L9.5mm_D4.0mm_P12.70mm_Horizontal_Fastron_SMCC
J4, J5: Joystick_Port; Joystick_Pport
Q4: 2N3906; TO-92_Inline
R8, R9, R10, R11, R13, R30, R31, R32, R34: 3k; R_1206_3216Metric_Pad1.42x1.75mm_HandSolder
R74, R75, R76, R77, R78, R79, R80, R81: 120; R_1206_3216Metric_Pad1.42x1.75mm_HandSolder
R82, R83, R84: 4k7; R_1206_3216Metric_Pad1.42x1.75mm_HandSolder
R85, R86, R87: 100; R_1206_3216Metric_Pad1.42x1.75mm_HandSolder
R88: 2k7; R_1206_3216Metric_Pad1.42x1.75mm_HandSolder
U1: PIA; DIP-40_W15.24mm_LongPads

Connections:
A0: U1.35 (A0); also elsewhere on the board
A1: U1.36 (A1); also elsewhere on the board
BACK0: J4.2 (Back), R75.1
BACK1: J5.2 (Back), R79.1
BO2: U1.25 (O2); also elsewhere on the board
COMMAND: R85.2; also elsewhere on the board
D0: U1.33 (D0); also elsewhere on the board
D1: U1.32 (D1); also elsewhere on the board
D2: U1.31 (D2); also elsewhere on the board
D3: U1.30 (D3); also elsewhere on the board
D4: U1.29 (D4); also elsewhere on the board
D5: U1.28 (D5); also elsewhere on the board
D6: U1.27 (D6); also elsewhere on the board
D7: U1.26 (D7); also elsewhere on the board
FWD0: J4.1 (FWD), R74.1
FWD1: J5.1 (FWD), R78.1
GND: C29.2, J4.8 (GND), J5.8 (GND), U1.1 (VSS); also elsewhere on the board
INTERRUPT: R86.2; also elsewhere on the board
IRQ: U1.37 (~IRQB), U1.38 (~IRQA); also elsewhere on the board
LEFT0: J4.3 (Left), R76.1
LEFT1: J5.3 (Left), R80.1
MTRCTL: FB10.1; also elsewhere on the board
unnamed: FB10.2, Q4.3 (C)
unnamed: FB12.1, J4.7 (VCC)
unnamed: FB13.1, J5.7 (VCC)
unnamed: Q4.2 (B), R88.2
unnamed: R8.2, U1.22 (CS0), U1.24 (CS1)
unnamed: R74.2, U1.2 (PA0)
unnamed: R75.2, U1.3 (PA1)
unnamed: R76.2, U1.4 (PA2)
unnamed: R77.2, U1.5 (PA3)
unnamed: R78.2, U1.6 (PA4)
unnamed: R79.2, U1.7 (PA5)
unnamed: R80.2, U1.8 (PA6)
unnamed: R81.2, U1.9 (PA7)
unnamed: R82.1, R86.1, U1.18 (CB1)
unnamed: R83.1, R85.1, U1.19 (CB2)
unnamed: R84.1, R87.1, U1.40 (CA1)
unnamed: R88.1, U1.39 (CA2)
PB0: R9.2, U1.10 (PB0); also elsewhere on the board
PB1: R10.2, U1.11 (PB1); also elsewhere on the board
PB2: R11.2, U1.12 (PB2); also elsewhere on the board
PB3: R13.2, U1.13 (PB3); also elsewhere on the board
PB4: R30.2, U1.14 (PB4); also elsewhere on the board
PB5: R31.2, U1.15 (PB5); also elsewhere on the board
PB6: R32.2, U1.16 (PB6); also elsewhere on the board
PB7: R34.2, U1.17 (PB7); also elsewhere on the board
PIA: U1.23 (~CS2); also elsewhere on the board
POTA01: J4.9 (Pot_A); also elsewhere on the board
POTA02: J5.9 (Pot_A); also elsewhere on the board
POTB01: J4.5 (Pot_B); also elsewhere on the board
POTB02: J5.5 (Pot_B); also elsewhere on the board
PROCEED: R87.2; also elsewhere on the board
READY: FB11.1; also elsewhere on the board
RIGHT0: J4.4 (Right), R77.1
RIGHT1: J5.4 (Right), R81.1
RST: U1.34 (~RST); also elsewhere on the board
R\W: U1.21 (R/~W); also elsewhere on the board
TRIG0: J4.6 (Trig); also elsewhere on the board
TRIG1: J5.6 (Trig); also elsewhere on the board
VCC: C29.1, FB11.2, FB12.2, FB13.2, Q4.1 (E), R8.1, R9.1, R10.1, R11.1, R13.1, R30.1, R31.1, R32.1, R34.1, R82.2, R83.2, R84.2, U1.20 (VCC); also elsewhere on the board

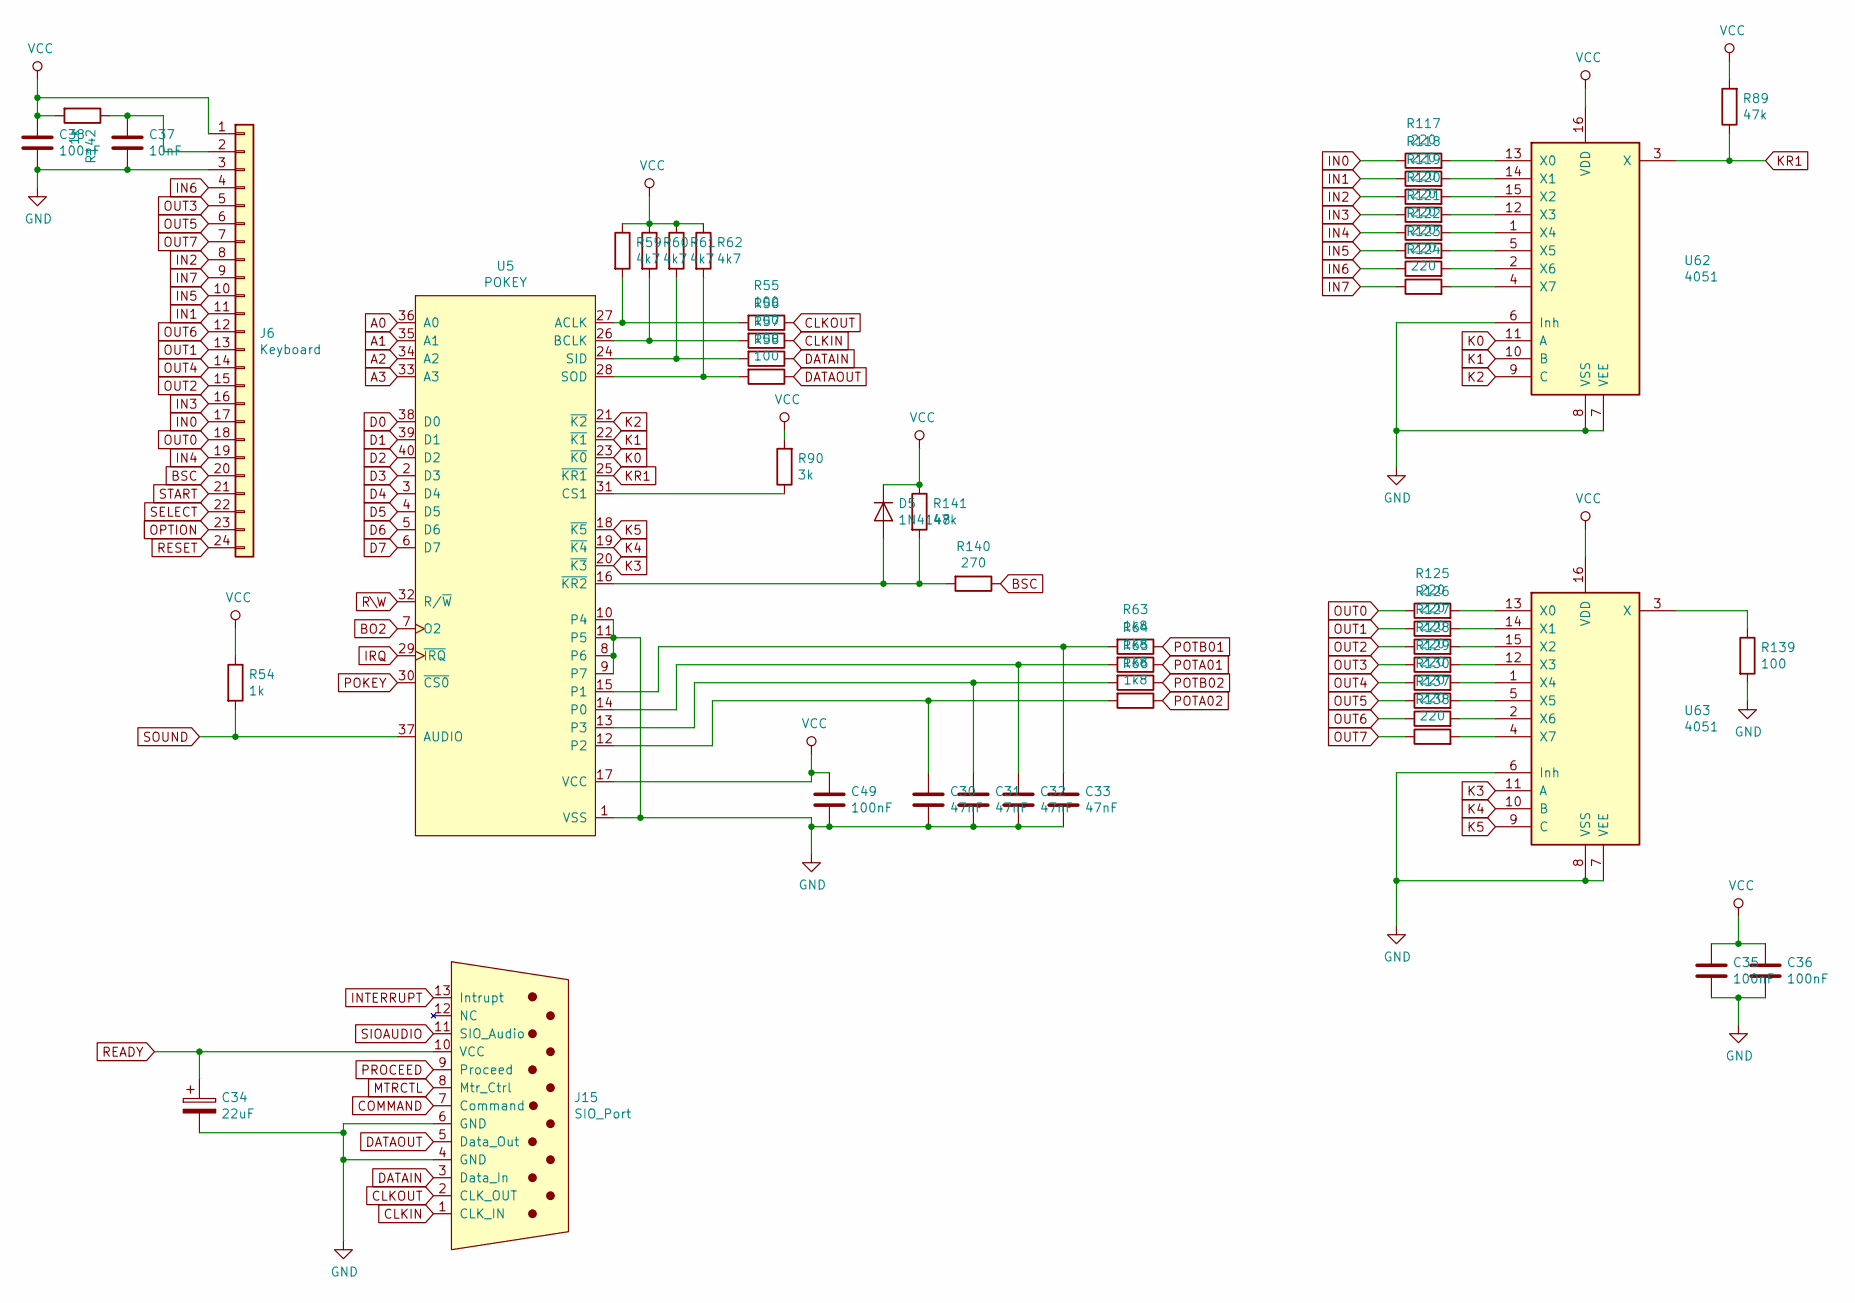
[picture p11: schematic POKEY.sch]

Parts:
C30, C31, C32, C33: 47nF; C_1206_3216Metric_Pad1.42x1.75mm_HandSolder
C34: 22uF; CP_Radial_D5.0mm_P2.00mm
C35, C36, C49: 100nF; C_Disc_D5.0mm_W2.5mm_P5.00mm
C37: 10nF; C_1206_3216Metric_Pad1.42x1.75mm_HandSolder
C38: 100nF; C_1206_3216Metric_Pad1.42x1.75mm_HandSolder
D5: 1N4148; D_MiniMELF_Handsoldering
J6: Keyboard; PinHeader_1x24_P2.54mm_Vertical
J15: SIO_Port; SIO_Slot
R54, R142: 1k; R_1206_3216Metric_Pad1.42x1.75mm_HandSolder
R55, R56, R57, R58, R139: 100; R_1206_3216Metric_Pad1.42x1.75mm_HandSolder
R59, R60, R61, R62: 4k7; R_1206_3216Metric_Pad1.42x1.75mm_HandSolder
R63, R64, R65, R66: 1k8; R_1206_3216Metric_Pad1.42x1.75mm_HandSolder
R89, R141: 47k; R_1206_3216Metric_Pad1.42x1.75mm_HandSolder
R90: 3k; R_1206_3216Metric_Pad1.42x1.75mm_HandSolder
R117, R118, R119, R120, R121, R122, R123, R124, R125, R126, R127, R128, R129, R130, R137, R138: 220; R_1206_3216Metric_Pad1.42x1.75mm_HandSolder
R140: 270; R_1206_3216Metric_Pad1.42x1.75mm_HandSolder
U5: POKEY; DIP-40_W15.24mm_LongPads
U62, U63: 4051; DIP-16_W7.62mm_Socket

Connections:
A0: U5.36 (A0); also elsewhere on the board
A1: U5.35 (A1); also elsewhere on the board
A2: U5.34 (A2); also elsewhere on the board
A3: U5.33 (A3); also elsewhere on the board
BO2: U5.7 (O2); also elsewhere on the board
BSC: J6.20, R140.1
CLKIN: J15.1 (CLK_IN), R56.1
CLKOUT: J15.2 (CLK_OUT), R55.1
COMMAND: J15.7 (Command); also elsewhere on the board
D0: U5.38 (D0); also elsewhere on the board
D1: U5.39 (D1); also elsewhere on the board
D2: U5.40 (D2); also elsewhere on the board
D3: U5.2 (D3); also elsewhere on the board
D4: U5.3 (D4); also elsewhere on the board
D5: U5.4 (D5); also elsewhere on the board
D6: U5.5 (D6); also elsewhere on the board
D7: U5.6 (D7); also elsewhere on the board
DATAIN: J15.3 (Data_In), R57.1
DATAOUT: J15.5 (Data_Out), R58.1
GND: C30.2, C31.2, C32.2, C33.2, C34.2, C35.2, C36.2, C37.2, C38.2, C49.2, J6.3, J15.4 (GND), J15.6 (GND), R139.2, U5.1 (VSS), U5.8 (P6), U5.9 (P7), U5.10 (P4), U5.11 (P5), U62.6 (Inh), U62.7 (VEE), U62.8 (VSS), U63.6 (Inh), U63.7 (VEE), U63.8 (VSS); also elsewhere on the board
IN0: J6.17, R117.1
IN1: J6.11, R118.1
IN2: J6.8, R119.1
IN3: J6.16, R120.1
IN4: J6.19, R121.1
IN5: J6.10, R122.1
IN6: J6.4, R123.1
IN7: J6.9, R124.1
INTERRUPT: J15.13 (Intrupt); also elsewhere on the board
IRQ: U5.29 (~IRQ); also elsewhere on the board
K0: U5.23 (~K0), U62.11 (A)
K1: U5.22 (~K1), U62.10 (B)
K2: U5.21 (~K2), U62.9 (C)
K3: U5.20 (~K3), U63.11 (A)
K4: U5.19 (~K4), U63.10 (B)
K5: U5.18 (~K5), U63.9 (C)
KR1: R89.1, U5.25 (~KR1), U62.3 (X)
MTRCTL: J15.8 (Mtr_Ctrl); also elsewhere on the board
unnamed: C30.1, R66.2, U5.12 (P2)
unnamed: C31.1, R65.2, U5.13 (P3)
unnamed: C32.1, R64.2, U5.14 (P0)
unnamed: C33.1, R63.2, U5.15 (P1)
unnamed: C37.1, J6.2, R142.1
unnamed: D5.2 (A), R140.2, R141.2, U5.16 (~KR2)
unnamed: R55.2, R59.2, U5.27 (ACLK)
unnamed: R56.2, R60.2, U5.26 (BCLK)
unnamed: R57.2, R61.2, U5.24 (SID)
unnamed: R58.2, R62.2, U5.28 (SOD)
unnamed: R90.1, U5.31 (CS1)
unnamed: R117.2, U62.13 (X0)
unnamed: R118.2, U62.14 (X1)
unnamed: R119.2, U62.15 (X2)
unnamed: R120.2, U62.12 (X3)
unnamed: R121.2, U62.1 (X4)
unnamed: R122.2, U62.5 (X5)
unnamed: R123.2, U62.2 (X6)
unnamed: R124.2, U62.4 (X7)
unnamed: R125.2, U63.13 (X0)
unnamed: R126.2, U63.14 (X1)
unnamed: R127.2, U63.15 (X2)
unnamed: R128.2, U63.12 (X3)
unnamed: R129.2, U63.1 (X4)
unnamed: R130.2, U63.5 (X5)
unnamed: R137.2, U63.2 (X6)
unnamed: R138.2, U63.4 (X7)
unnamed: R139.1, U63.3 (X)
OPTION: J6.23; also elsewhere on the board
OUT0: J6.18, R125.1
OUT1: J6.13, R126.1
OUT2: J6.15, R127.1
OUT3: J6.5, R128.1
OUT4: J6.14, R129.1
OUT5: J6.6, R130.1
OUT6: J6.12, R137.1
OUT7: J6.7, R138.1
POKEY: U5.30 (~CS0); also elsewhere on the board
POTA01: R64.1; also elsewhere on the board
POTA02: R66.1; also elsewhere on the board
POTB01: R63.1; also elsewhere on the board
POTB02: R65.1; also elsewhere on the board
PROCEED: J15.9 (Proceed); also elsewhere on the board
READY: C34.1, J15.10 (VCC); also elsewhere on the board
RESET: J6.24; also elsewhere on the board
R\W: U5.32 (R/~W); also elsewhere on the board
SELECT: J6.22; also elsewhere on the board
SIOAUDIO: J15.11 (SIO_Audio); also elsewhere on the board
SOUND: R54.2, U5.37 (AUDIO); also elsewhere on the board
START: J6.21; also elsewhere on the board
VCC: C35.1, C36.1, C38.1, C49.1, D5.1 (K), J6.1, R54.1, R59.1, R60.1, R61.1, R62.1, R89.2, R90.2, R141.1, R142.2, U5.17 (VCC), U62.16 (VDD), U63.16 (VDD); also elsewhere on the board

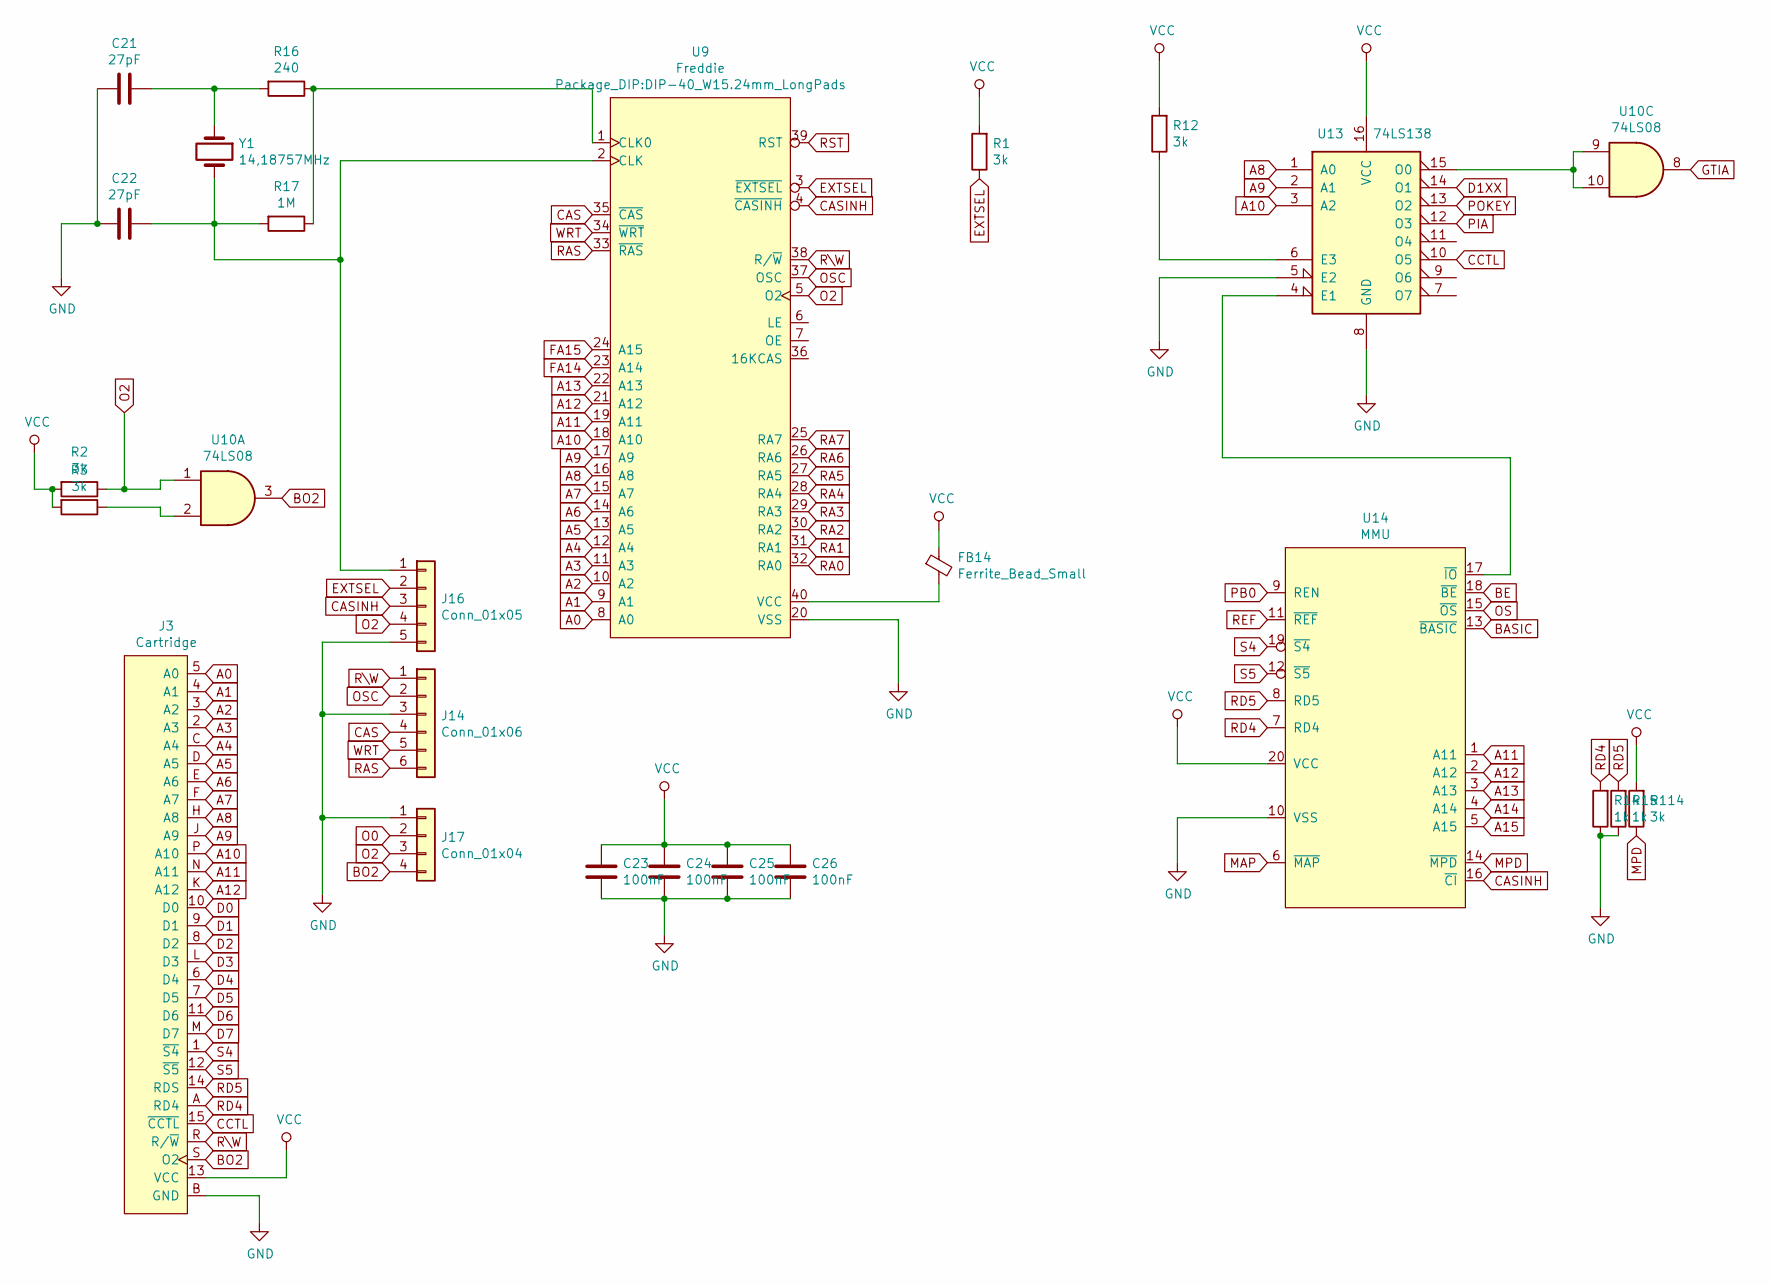
[picture p12: schematic Freddie.sch]

Parts:
C21, C22: 27pF; C_Disc_D3.0mm_W2.0mm_P2.50mm
C23, C24, C25, C26: 100nF; C_Disc_D5.0mm_W2.5mm_P5.00mm
FB14: Ferrite_Bead_Small; L_Axial_L7.0mm_D3.3mm_P10.16mm_Horizontal_Fastron_MICC
J3: Cartridge; Cartridge_Slot
J14: Conn_01x06; PinHeader_1x06_P2.54mm_Vertical
J16: Conn_01x05; PinHeader_1x05_P2.54mm_Vertical
J17: Conn_01x04; PinHeader_1x04_P2.54mm_Vertical
R1: 3k; R_Axial_DIN0207_L3.6mm_D2.2mm_P10.16mm_Horizontal
R2, R3, R12, R114: 3k; R_1206_3216Metric_Pad1.42x1.75mm_HandSolder
R14, R15: 1k; R_1206_3216Metric_Pad1.42x1.75mm_HandSolder
R16: 240; R_Axial_DIN0207_L3.6mm_D2.2mm_P10.16mm_Horizontal
R17: 1M; R_Axial_DIN0207_L3.6mm_D2.2mm_P10.16mm_Horizontal
U9: Freddie; DIP-40_W15.24mm_LongPads
U10: 74LS08; DIP-14_W7.62mm_Socket_LongPads
U13: 74LS138; DIP-16_W7.62mm_Socket_LongPads
U14: MMU; DIP-20_W7.62mm_LongPads
Y1: 14,18757MHz; Crystal_HC18-U_Vertical

Connections:
A0: J3.5 (A0), U9.8 (A0); also elsewhere on the board
A1: J3.4 (A1), U9.9 (A1); also elsewhere on the board
A2: J3.3 (A2), U9.10 (A2); also elsewhere on the board
A3: J3.2 (A3), U9.11 (A3); also elsewhere on the board
A4: J3.C (A4), U9.12 (A4); also elsewhere on the board
A5: J3.D (A5), U9.13 (A5); also elsewhere on the board
A6: J3.E (A6), U9.14 (A6); also elsewhere on the board
A7: J3.F (A7), U9.15 (A7); also elsewhere on the board
A8: J3.H (A8), U9.16 (A8), U13.1 (A0); also elsewhere on the board
A9: J3.J (A9), U9.17 (A9), U13.2 (A1); also elsewhere on the board
A10: J3.P (A10), U9.18 (A10), U13.3 (A2); also elsewhere on the board
A11: J3.N (A11), U9.19 (A11), U14.1 (A11); also elsewhere on the board
A12: J3.K (A12), U9.21 (A12), U14.2 (A12); also elsewhere on the board
A13: U9.22 (A13), U14.3 (A13); also elsewhere on the board
A14: U14.4 (A14); also elsewhere on the board
A15: U14.5 (A15); also elsewhere on the board
BASIC: U14.13 (~BASIC); also elsewhere on the board
BE: U14.18 (~BE); also elsewhere on the board
BO2: J3.S (O2), J17.4, U10.3; also elsewhere on the board
CAS: J14.4, U9.35 (~CAS); also elsewhere on the board
CASINH: J16.3, U9.4 (~CASINH), U14.16 (~CI)
CCTL: J3.15 (~CCTL), U13.10 (O5); also elsewhere on the board
D0: J3.10 (D0); also elsewhere on the board
D1: J3.9 (D1); also elsewhere on the board
D2: J3.8 (D2); also elsewhere on the board
D3: J3.L (D3); also elsewhere on the board
D4: J3.6 (D4); also elsewhere on the board
D5: J3.7 (D5); also elsewhere on the board
D6: J3.11 (D6); also elsewhere on the board
D7: J3.M (D7); also elsewhere on the board
EXTSEL: J16.2, R1.1, U9.3 (~EXTSEL)
FA14: U9.23 (A14); also elsewhere on the board
FA15: U9.24 (A15); also elsewhere on the board
GND: C21.2, C22.2, C23.2, C24.2, C25.2, C26.2, J3.B (GND), J14.3, J16.5, J17.1, R14.1, R15.1, U9.20 (VSS), U13.5 (E2), U13.8 (GND), U14.10 (VSS); also elsewhere on the board
GTIA: U10.8; also elsewhere on the board
MAP: U14.6 (~MAP); also elsewhere on the board
MPD: R114.1, U14.14 (~MPD)
unnamed: C21.1, R16.2, Y1.1
unnamed: C22.1, J16.1, R17.2, U9.2 (CLK), Y1.2
unnamed: FB14.2, U9.40 (VCC)
unnamed: R3.1, U10.2
unnamed: R12.1, U13.6 (E3)
unnamed: R16.1, R17.1, U9.1 (CLK0)
unnamed: U10.9, U10.10, U13.15 (O0)
unnamed: U13.4 (E1), U14.17 (~IO)
O0: J17.2; also elsewhere on the board
O2: J16.4, J17.3, R2.1, U9.5 (O2), U10.1; also elsewhere on the board
OS: U14.15 (~OS); also elsewhere on the board
OSC: J14.2, U9.37 (OSC); also elsewhere on the board
PB0: U14.9 (REN); also elsewhere on the board
PIA: U13.12 (O3); also elsewhere on the board
POKEY: U13.13 (O2); also elsewhere on the board
RA0: U9.32 (RA0); also elsewhere on the board
RA1: U9.31 (RA1); also elsewhere on the board
RA2: U9.30 (RA2); also elsewhere on the board
RA3: U9.29 (RA3); also elsewhere on the board
RA4: U9.28 (RA4); also elsewhere on the board
RA5: U9.27 (RA5); also elsewhere on the board
RA6: U9.26 (RA6); also elsewhere on the board
RA7: U9.25 (RA7); also elsewhere on the board
RAS: J14.6, U9.33 (~RAS); also elsewhere on the board
RD4: J3.A (RD4), R14.2, U14.7 (RD4)
RD5: J3.14 (RDS), R15.2, U14.8 (RD5); also elsewhere on the board
REF: U14.11 (~REF); also elsewhere on the board
RST: U9.39 (RST); also elsewhere on the board
R\W: J3.R (R/~W), J14.1, U9.38 (R/~W); also elsewhere on the board
S4: J3.1 (~S4), U14.19 (~S4)
S5: J3.12 (~S5), U14.12 (~S5)
VCC: C23.1, C24.1, C25.1, C26.1, FB14.1, J3.13 (VCC), R1.2, R2.2, R3.2, R12.2, R114.2, U13.16 (VCC), U14.20 (VCC); also elsewhere on the board
WRT: J14.5, U9.34 (~WRT); also elsewhere on the board

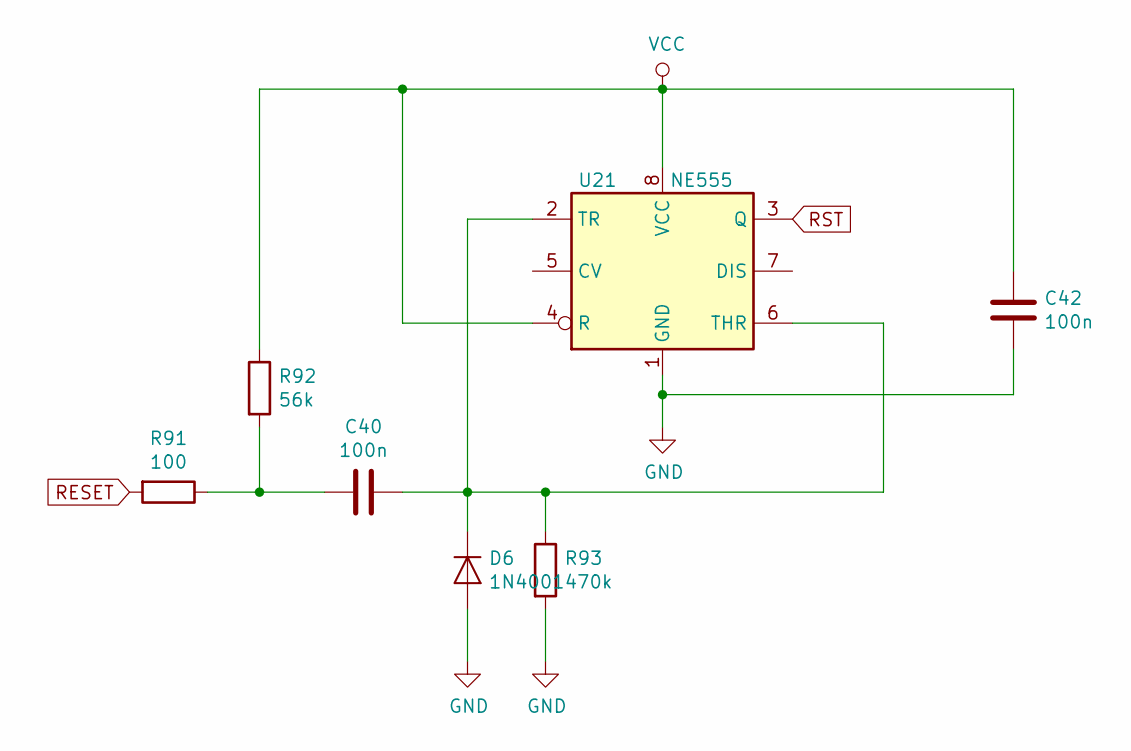
[picture p13: schematic Reset i sound.sch]

Parts:
C40, C42: 100n; C_1206_3216Metric_Pad1.42x1.75mm_HandSolder
D6: 1N4001; D_MiniMELF_Handsoldering
R91: 100; R_1206_3216Metric_Pad1.42x1.75mm_HandSolder
R92: 56k; R_1206_3216Metric_Pad1.42x1.75mm_HandSolder
R93: 470k; R_1206_3216Metric_Pad1.42x1.75mm_HandSolder
U21: NE555; DIP-8_W7.62mm_LongPads

Connections:
GND: C42.2, D6.2 (A), R93.2, U21.1 (GND); also elsewhere on the board
unnamed: C40.1, D6.1 (K), R93.1, U21.2 (TR), U21.6 (THR)
unnamed: C40.2, R91.1, R92.2
RESET: R91.2; also elsewhere on the board
RST: U21.3 (Q); also elsewhere on the board
VCC: C42.1, R92.1, U21.4 (R), U21.8 (VCC); also elsewhere on the board

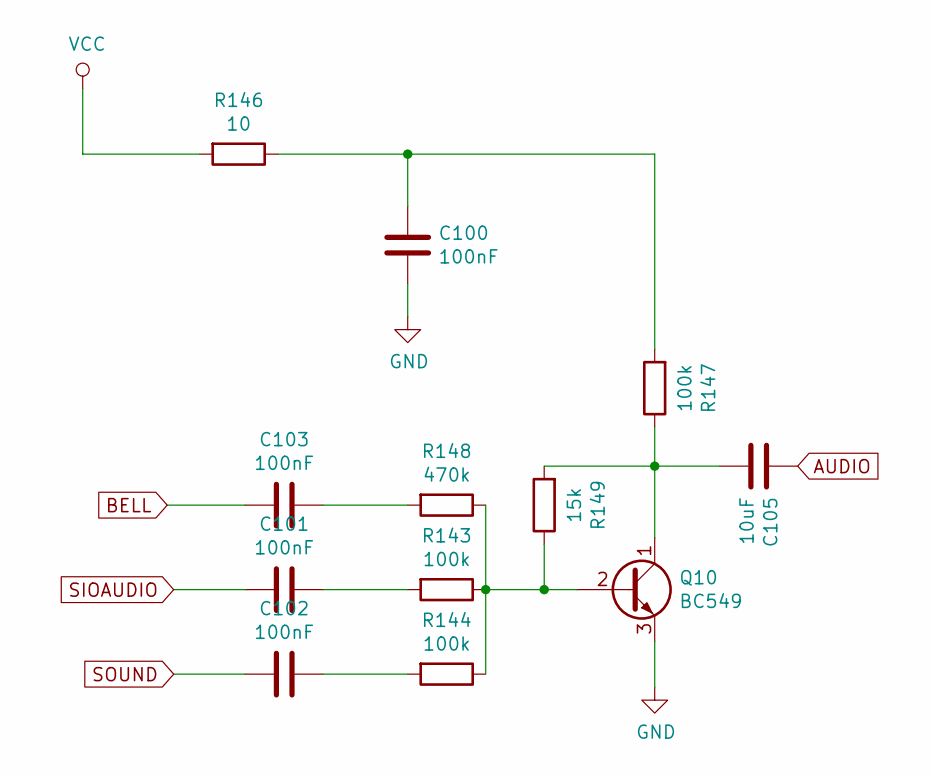
[picture p14: schematic Audio.sch]

Parts:
C100, C101, C102, C103: 100nF; C_Disc_D5.0mm_W2.5mm_P5.00mm
C105: 10uF; C_1812_4532Metric_Pad1.30x3.40mm_HandSolder
Q10: BC549; TO-92_Inline
R143, R144, R147: 100k; R_Axial_DIN0207_L3.6mm_D2.2mm_P10.16mm_Horizontal
R146: 10; R_Axial_DIN0207_L3.6mm_D2.2mm_P10.16mm_Horizontal
R148: 470k; R_Axial_DIN0207_L3.6mm_D2.2mm_P10.16mm_Horizontal
R149: 15k; R_Axial_DIN0207_L3.6mm_D2.2mm_P10.16mm_Horizontal

Connections:
AUDIO: C105.2; also elsewhere on the board
BELL: C103.1; also elsewhere on the board
GND: C100.1, Q10.3 (E); also elsewhere on the board
unnamed: C100.2, R146.1, R147.2
unnamed: C101.2, R143.2
unnamed: C102.2, R144.2
unnamed: C103.2, R148.2
unnamed: C105.1, Q10.1 (C), R147.1, R149.2
unnamed: Q10.2 (B), R143.1, R144.1, R148.1, R149.1
SIOAUDIO: C101.1; also elsewhere on the board
SOUND: C102.1; also elsewhere on the board
VCC: R146.2; also elsewhere on the board

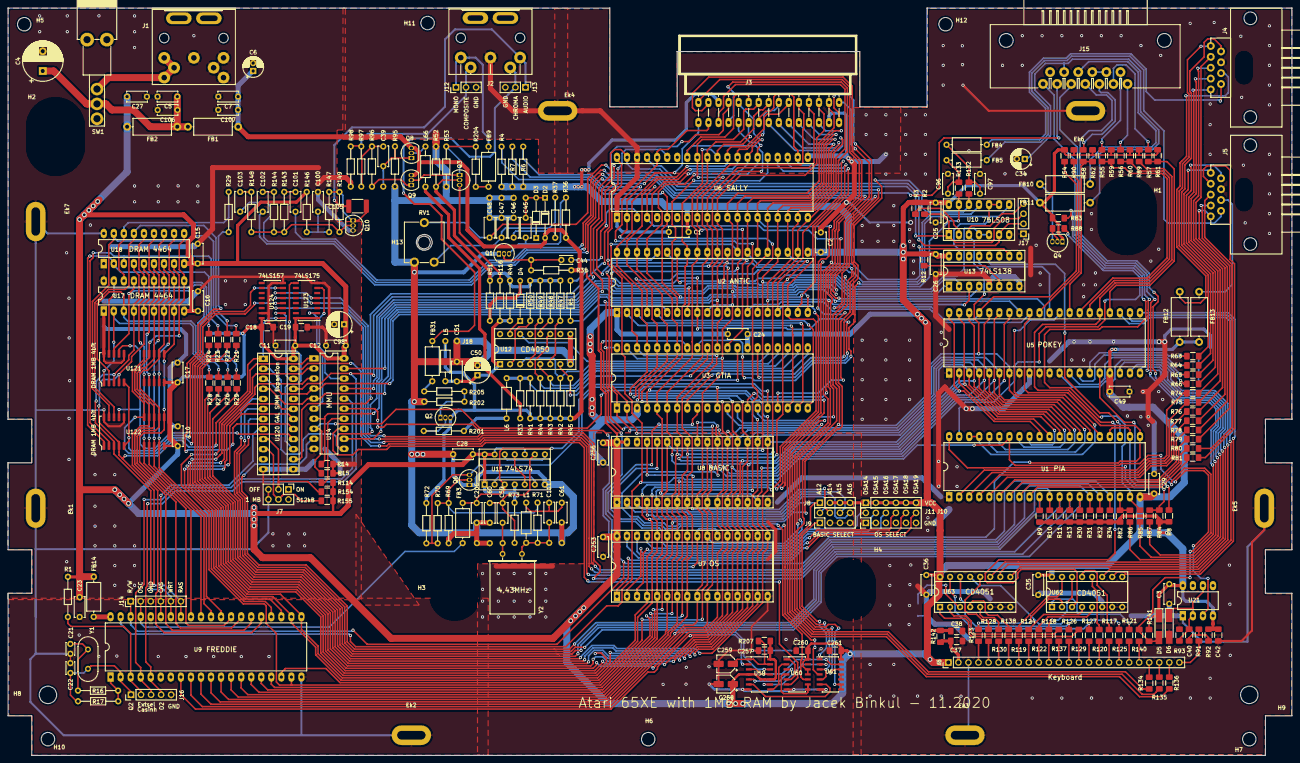
[picture p15: board Atari 130XE.kicad_pcb from above]

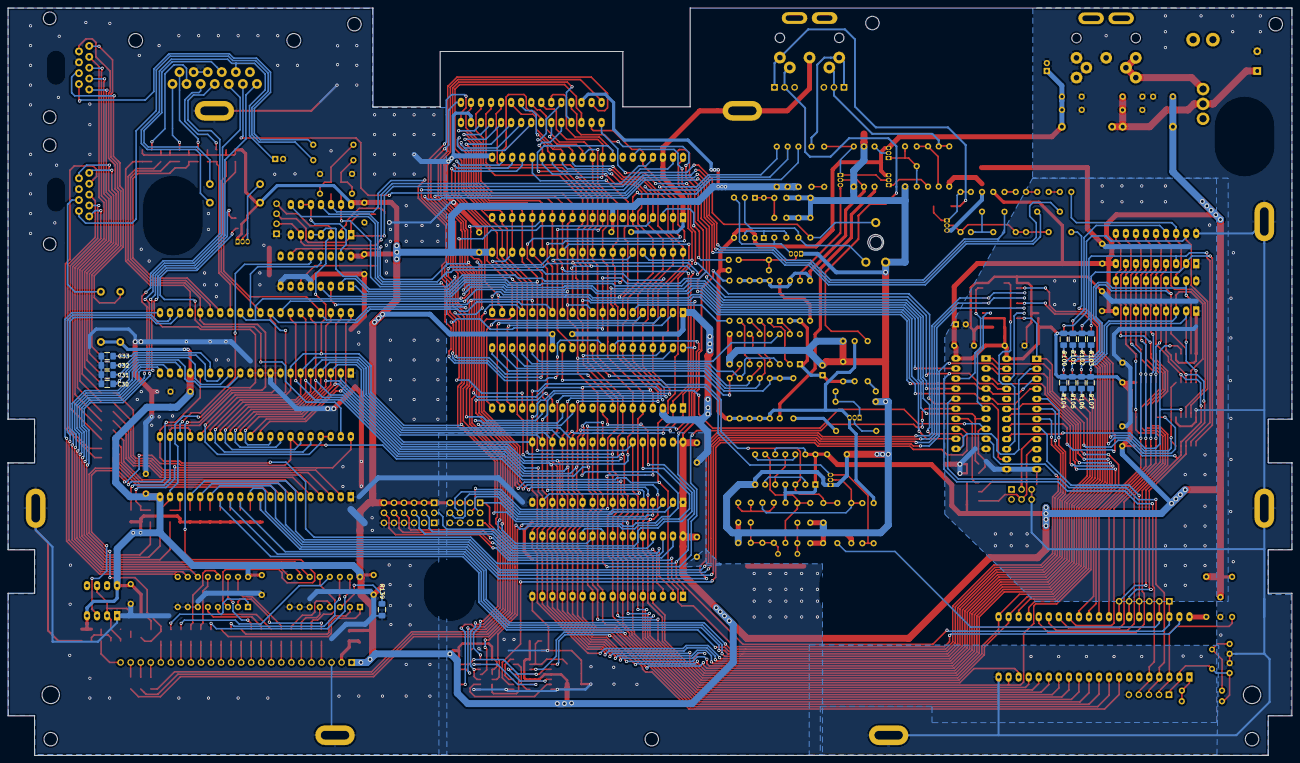
[picture p16: board Atari 130XE.kicad_pcb from below]

Board: 2 copper layers, 324.7 x 189.0 mm, 311 parts (13 on the bottom side), 291 nets.
