binkul/Atari_65XE_scheme/(commit log)

2020-10-25 Global rebuild up to 1mB
    [Atari 130XE.kicad_pcb, Basic.sch, GTIA.sch, Memory.sch]
2020-10-28 memory track
    [Atari 130XE.kicad_pcb, External Memory.sch]
2020-10-30 memory connection
    [Atari 130XE.kicad_pcb]
2020-10-30 SIMM exp route
    [Atari 130XE.kicad_pcb]
2020-11-03 Crystal track
    [Atari 130XE.kicad_pcb]
2020-11-20 Track OS and Basic
    [Atari 130XE.kicad_pcb, Atari OS.sch, Basic.sch]
2020-11-22 Finished GND
    [Atari 130XE.kicad_pcb, External Memory.sch, Freddie.sch, GTIA.sch, PIA.sch, Power.sch]
2020-11-24 Improve gerber
    [Atari 130XE-B_Cu.gbl, Atari 130XE-B_Mask.gbs, Atari 130XE-B_SilkS.gbo, Atari 130XE-Edge_Cuts.gm1, Atari 130XE-F_Cu.gtl, Atari 130XE-F_Mask.gts, Atari 130XE-F_SilkS.gto, Atari 130XE-NPTH.drl]
